lpozdneev/team-buzz/Website/images/mayur.png

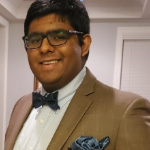
Website/images/mayur.png
