lpozdneev/team-buzz/Website/documents/pres1.pdf

Team Buzz: Stefan Abi-Karam, Evan Burke, Abigail Ivemeyer, Leonid Pozdneev, Mayur Singh, & Ethan Taylor

## HyTech Racing BMS: Presentation 1

02/17/2021

1. Introduction/Background (Abi)
2. Categories of Prior Art (Ethan)
3. Existing Products/Prior Art/Applicable Patents (Ethan)
4. Prior Art/HyTech BMS Design (Leo)
5. Customer Requirements/Design Specifications (Leo)
6. Design Concept Ideation: General System Diagram (Stefan)
7. Design Concept Ideation: Morphological Chart (Evan+Mayur)
8. Design Concept Ideation: Electrical System Diagram (Stefan)

### Order of Presentation

- HyTech racing is interested in a custom battery management
system, a data recording
system, and a user interface for charging Lithium Cobalt Oxide pouch battery cells

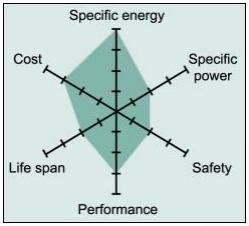
[picture p7: figure]

- The end goal is efficient battery charging and health estimation

### Introduction / Background

- Lithium Cobalt Oxide batteries are used because of their high specific energy but are limited by short lifespans

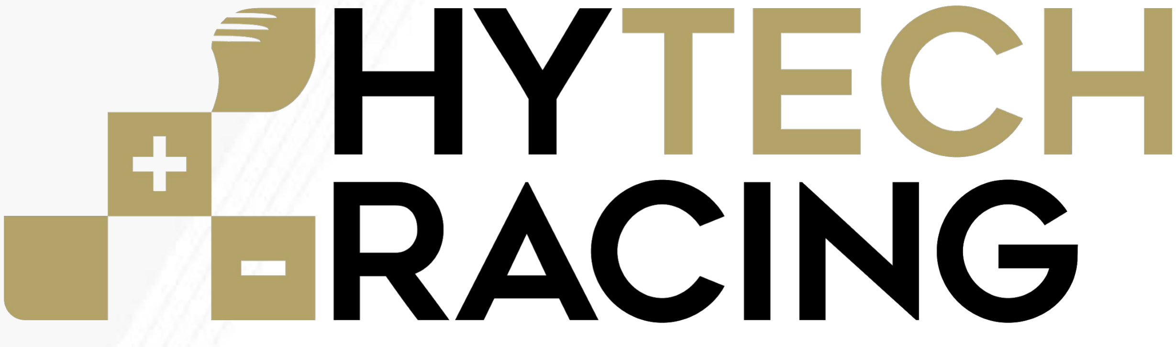
[picture p8: figure]

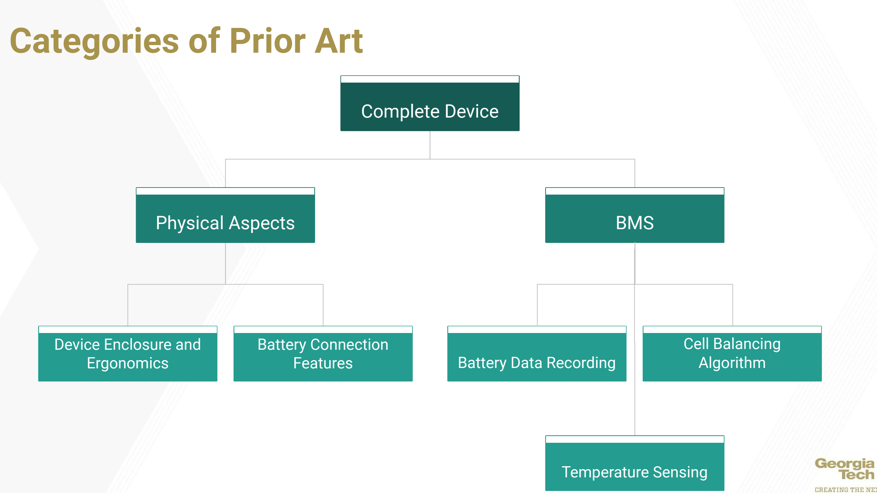
[picture p9: figure]
Complete Device; Physical Aspects; BMS; Cell Balancing; Battery Data Recording; Algorithm; Battery Connection Features; Device Enclosure and Ergonomics; Temperature Sensing; Categories of Prior Art

HyTech Racing:
- Already have a
pre-existing BMS design
utilizes LTC6804 Multicell Battery Monitors with
voltage logging using a
Tensey 3.2 microcontoller
- This design has already
been thoroughly tested
- More functionality is still to desired (logging
storage, temperature
monitoring, mechanical
design)

### Existing Products / Prior Art / Applicable Patents

Orion BMS
- Was used previously by
HyTech
- Has many great features
and is field programmable
- Orion BMS in the end was not a desirable solution for HyTech
- Large size and weight
- A lot of features that were not needed

Patents

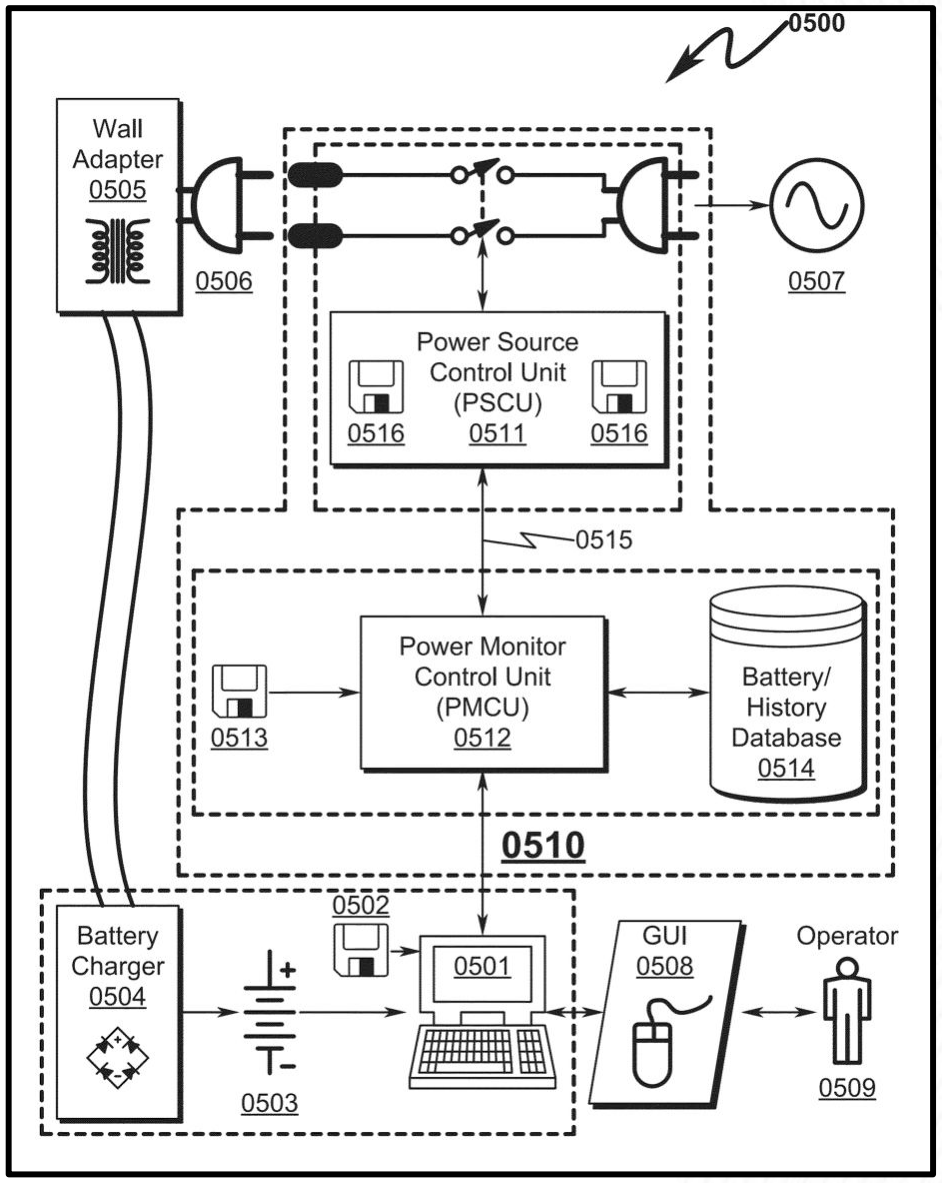
[picture p10: figure]

### Prior Art: HyTech BMS Design

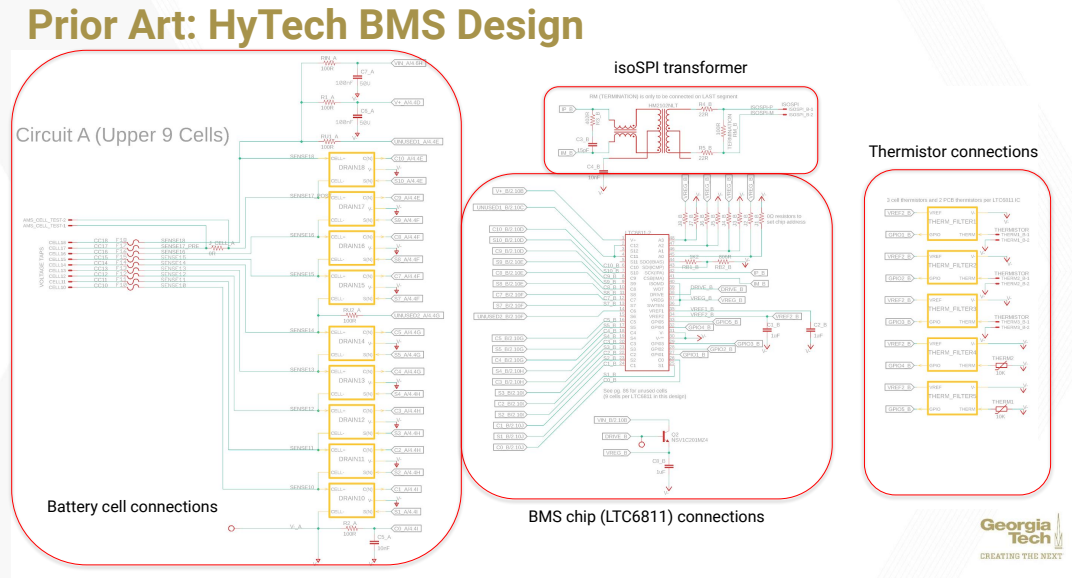
[picture p11: page 6]
isoSPI transformer; Thermistor connections

Battery cell connections

BMS chip (LTC6811) connections

### Prior Art: HyTech BMS Design

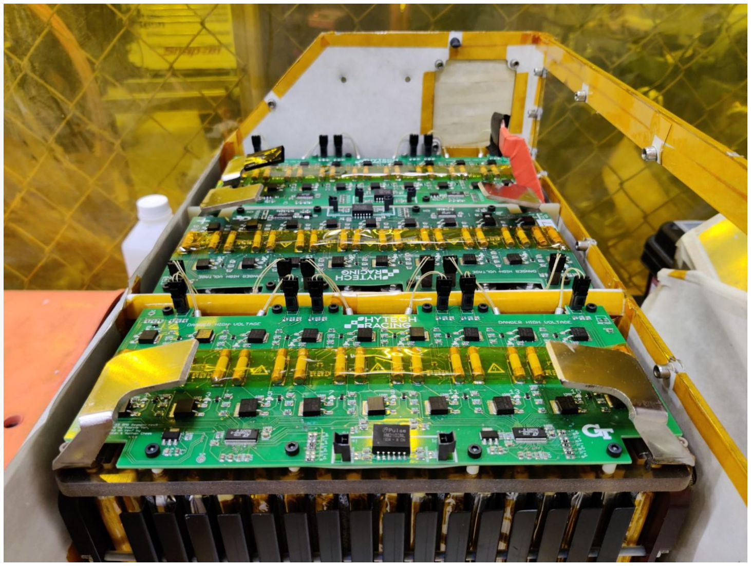
[picture p12: figure]

- Function
- Charge 9 LiCoO2 Battery Cells with nominal capacity of 18Ah
- Record and store current and voltage data for every cell
- Must be compatible with Melasta SLPBA580183 battery cells
- Electrical Characteristics
- Charging current of 9A (0.5C)
- Must have a cell balancing algorithm
- Powered from a regular electrical wall outlet
- Safety
- Must be easy and safe to use

Customer Requirements / Design Specifications

### Design Concept Ideation: General System Diagram

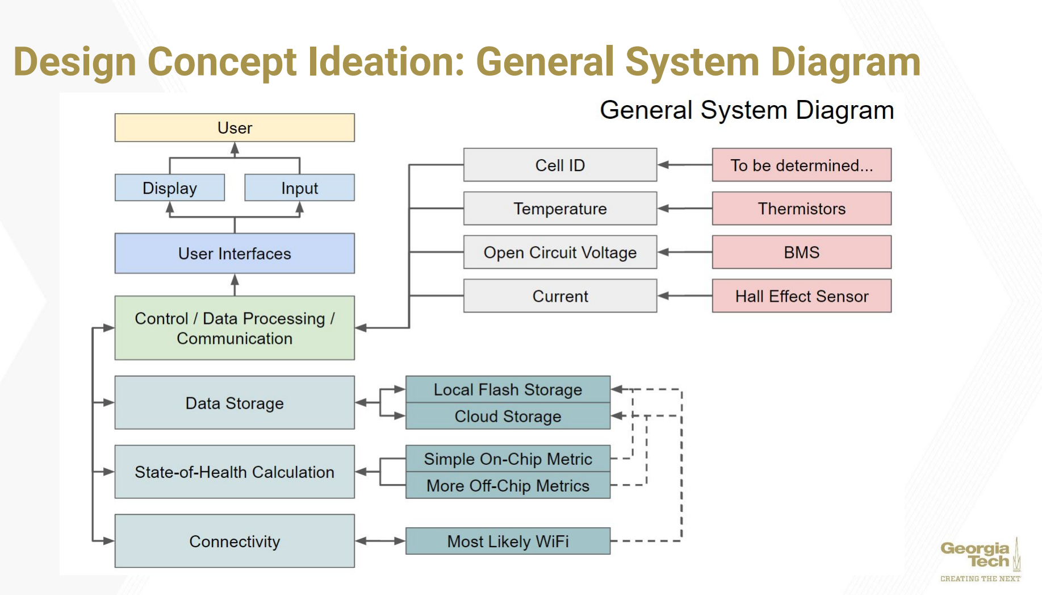
[picture p13: page 9]

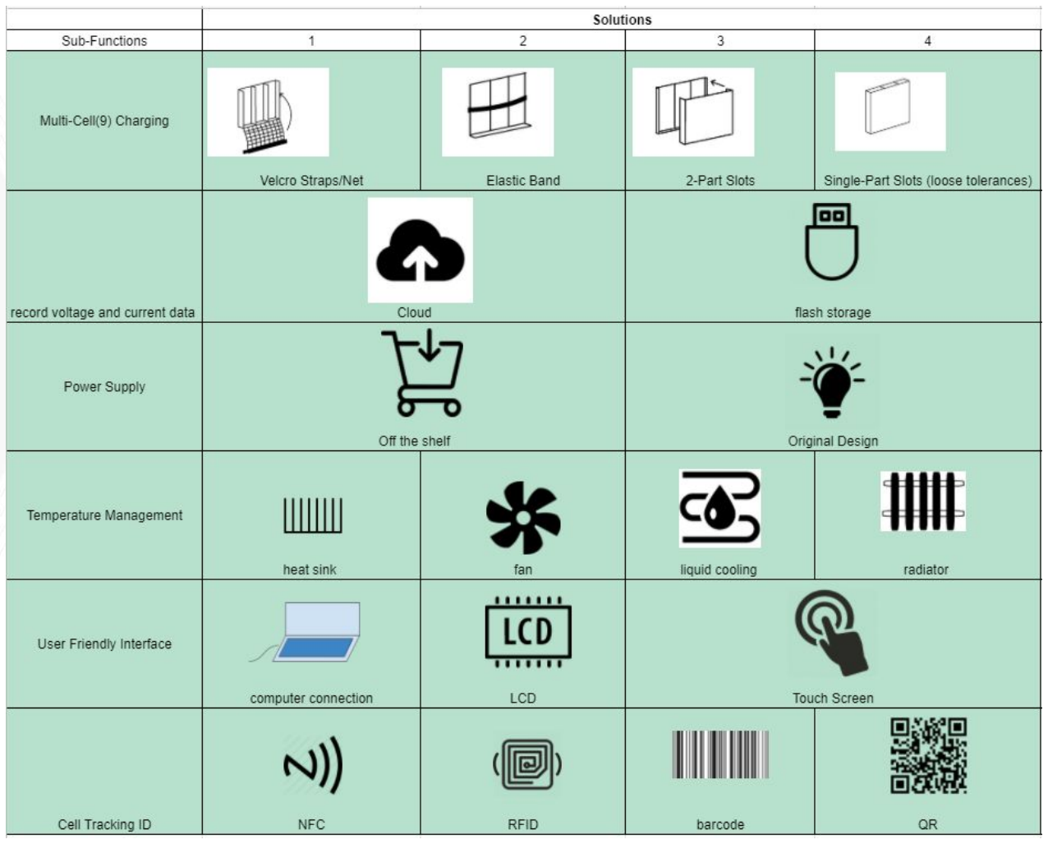
[picture p14: figure]

Morphological Chart:

### Design Concept Ideation

### Design Concept Ideation: Electrical System Diagram

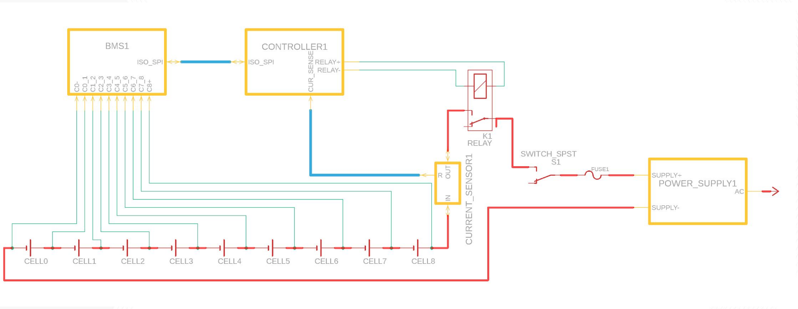
[picture p15: figure]
