lpozdneev/team-buzz/Battery Analysis/charge_data.png

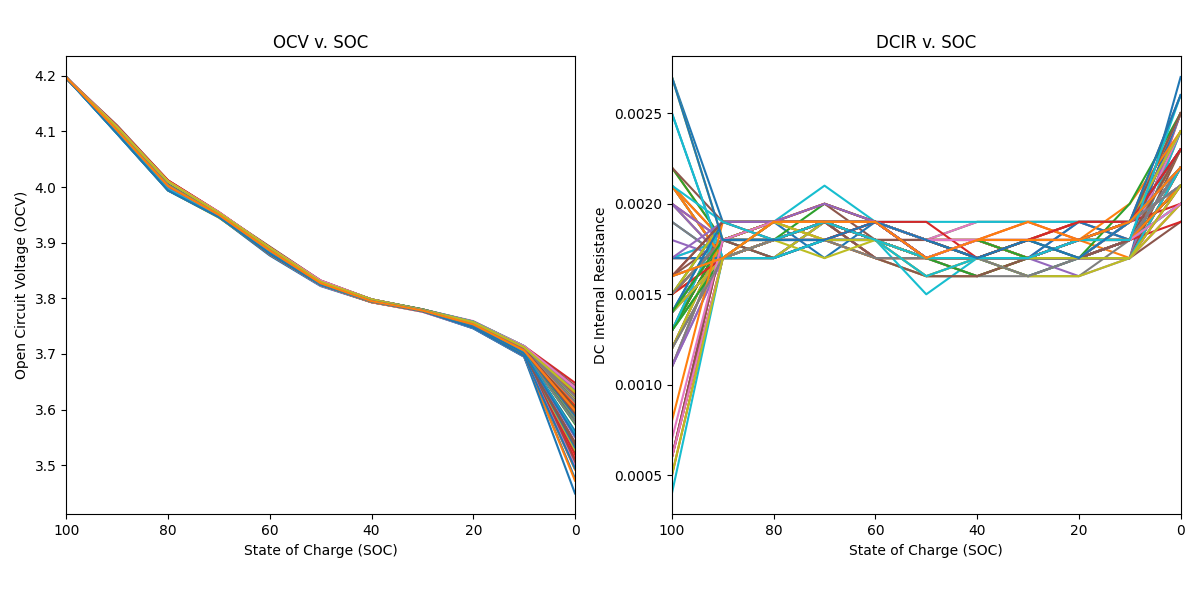
Battery Analysis/charge_data.png
