lpozdneev/team-buzz/Schematics/Cell Charger Controller/Cell Charger Controller rev1 brd.png

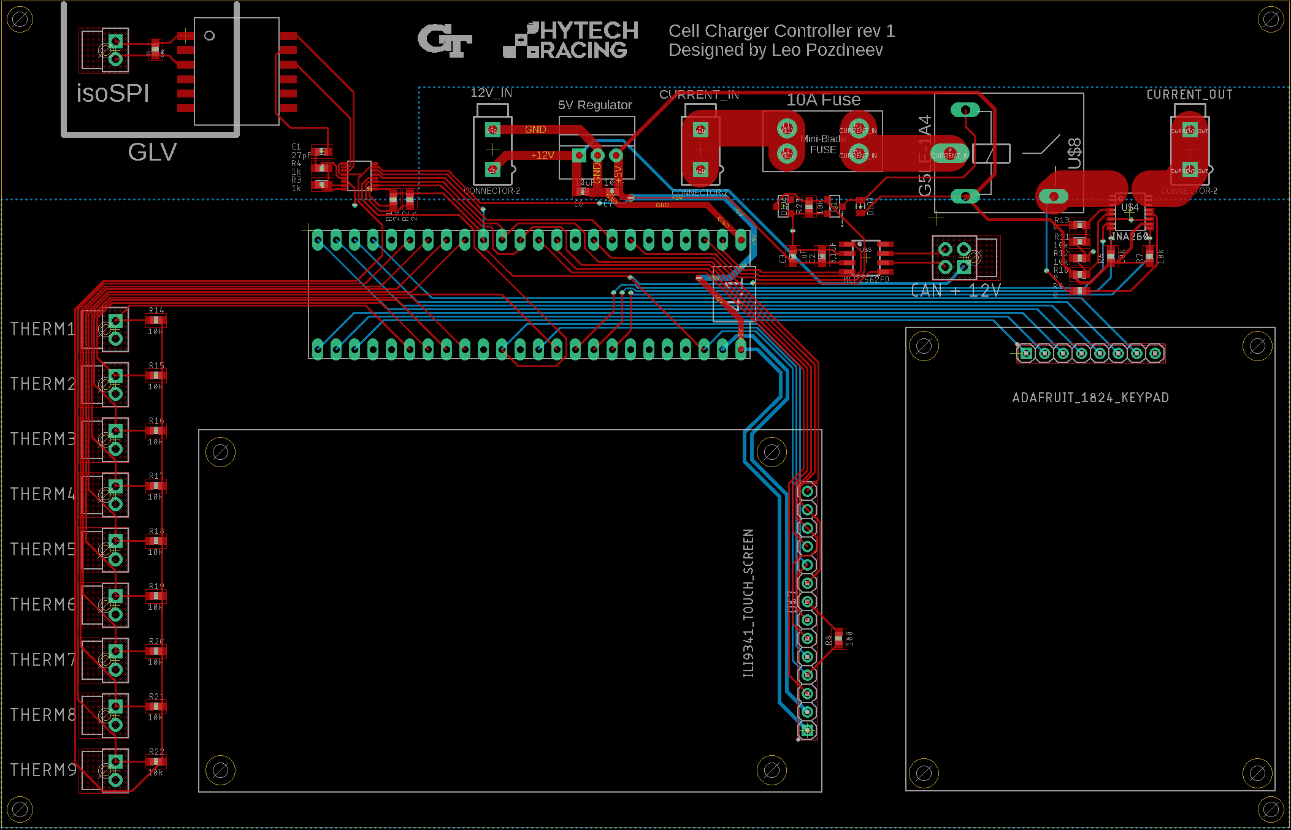
Schematics/Cell Charger Controller/Cell Charger Controller rev1 brd.png
