lpozdneev/team-buzz/Schematics/Cell Charger Controller/Cell Charger Controller rev1 sch.png

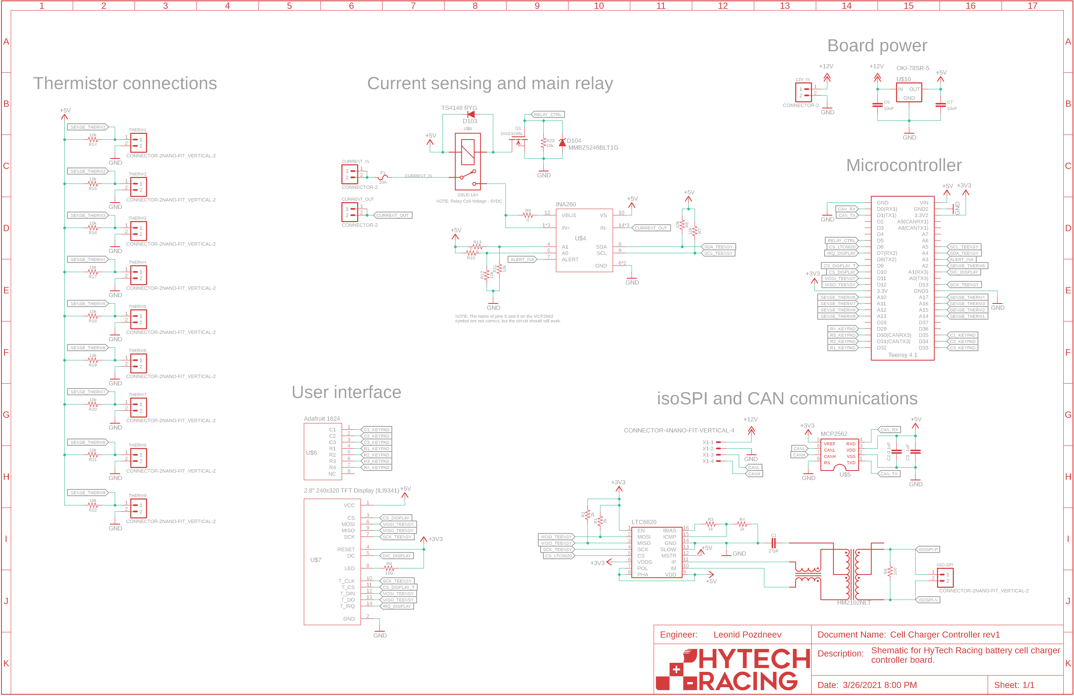
Schematics/Cell Charger Controller/Cell Charger Controller rev1 sch.png
