lpozdneev/team-buzz/Schematics/HyTech BMS Segment/BMS Segment rev 14 cell connections.png

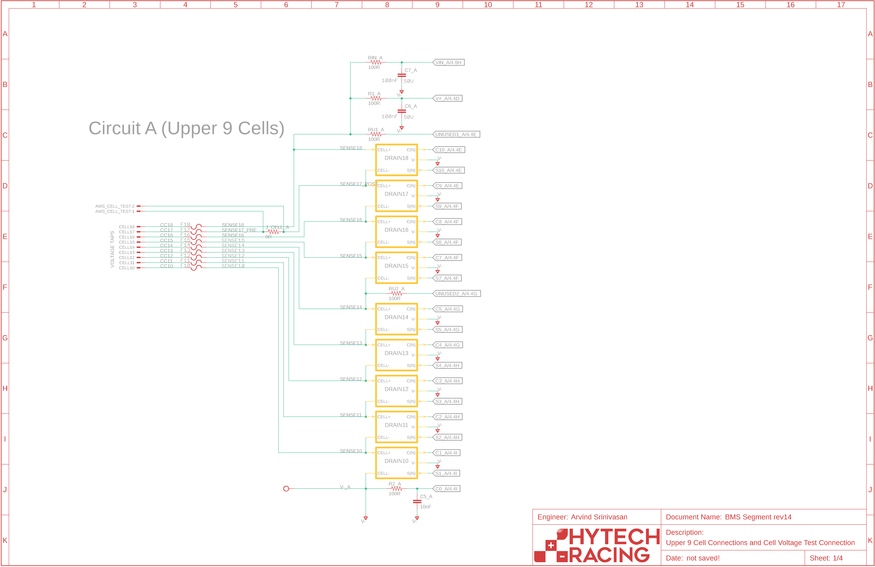
Schematics/HyTech BMS Segment/BMS Segment rev 14 cell connections.png
