lpozdneev/team-buzz/Schematics/System Diagrams/Full System Diagram rev1.png

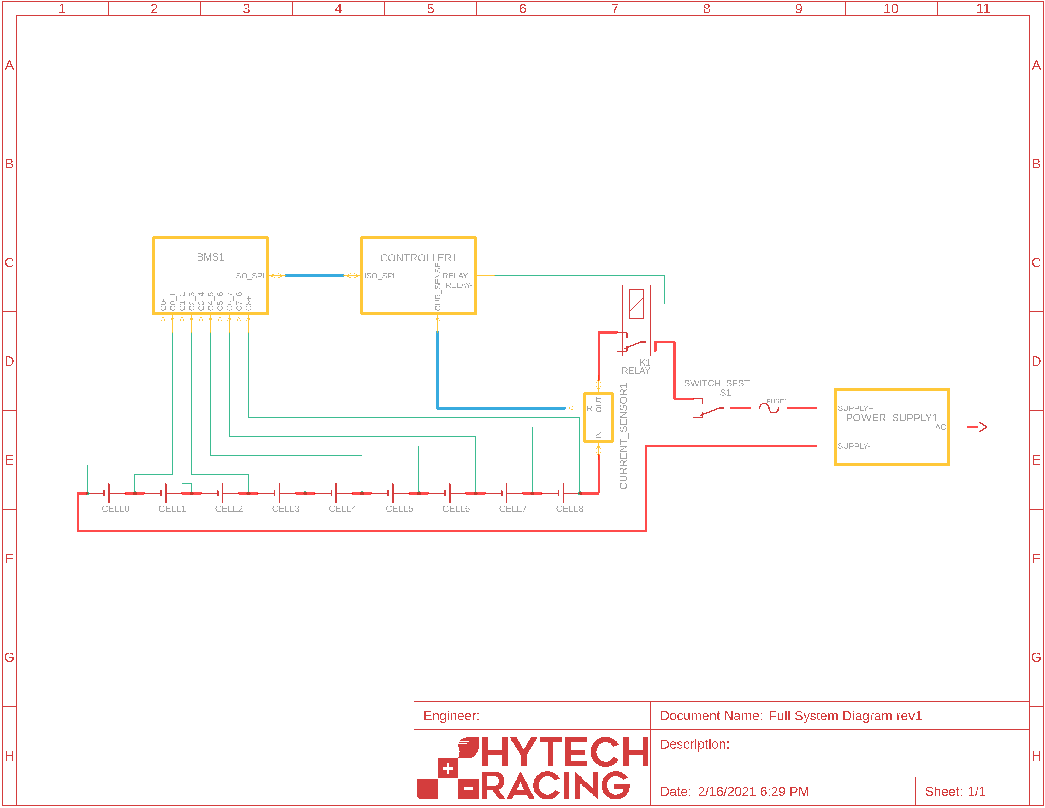
Schematics/System Diagrams/Full System Diagram rev1.png
