lpozdneev/team-buzz/Website/images/abigail.png

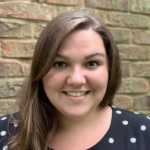
Website/images/abigail.png
