lpozdneev/team-buzz/Website/images/ethan.png

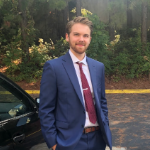
Website/images/ethan.png
