lpozdneev/team-buzz/Website/images/evan.png

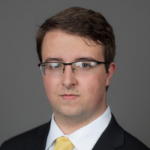
Website/images/evan.png
