lpozdneev/team-buzz/Website/images/leo.png

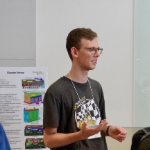
Website/images/leo.png
