lpozdneev/team-buzz/Website/images/new_bms.jpg

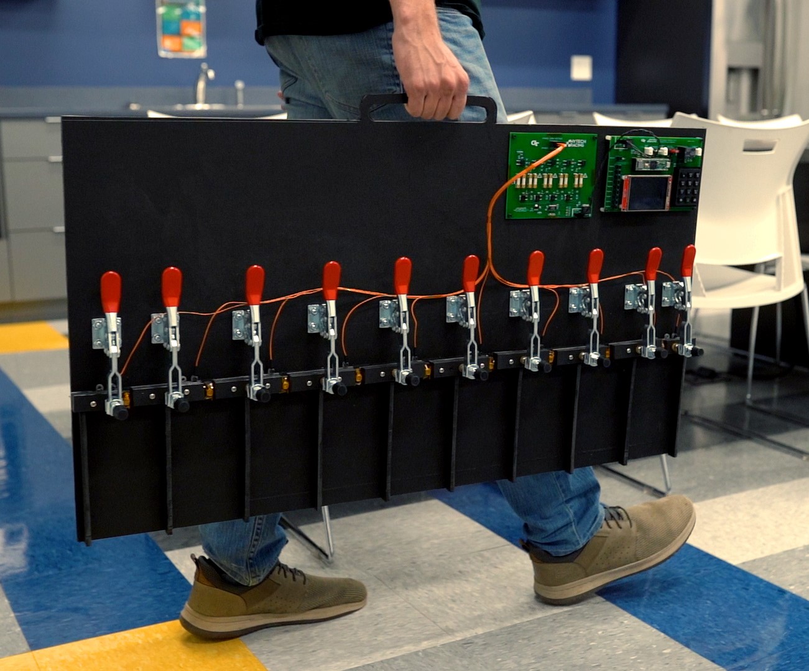
Website/images/new_bms.jpg
