lpozdneev/team-buzz/Website/images/original/abigail.png

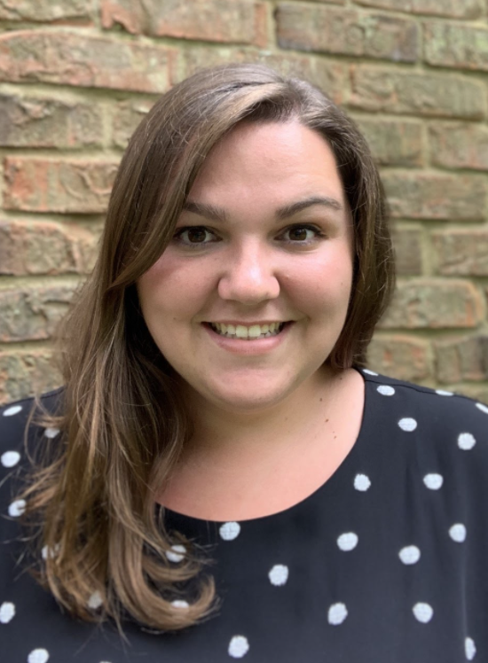
Website/images/original/abigail.png
