lpozdneev/team-buzz/Website/images/original/ethan.png

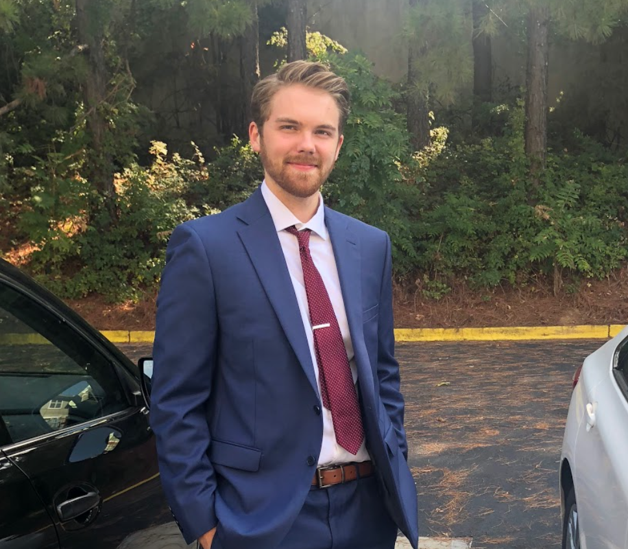
Website/images/original/ethan.png
