lpozdneev/team-buzz/Website/images/original/mayur.png

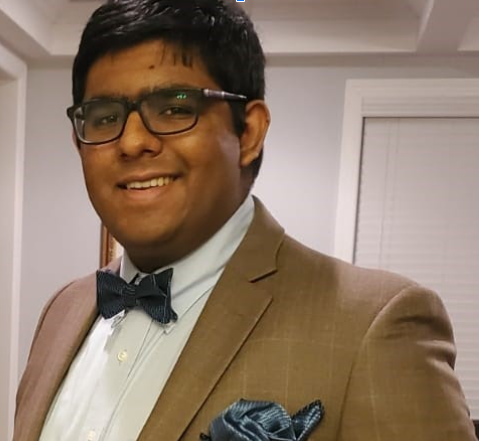
Website/images/original/mayur.png
