lpozdneev/team-buzz/Website/images/original/stefan.png

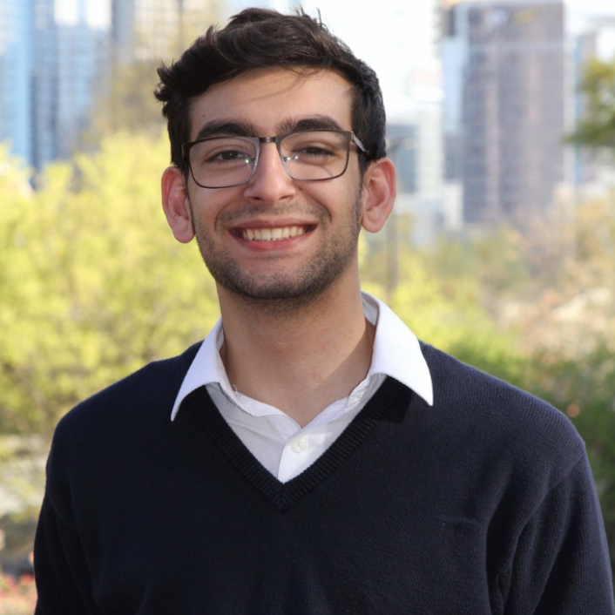
Website/images/original/stefan.png
