lpozdneev/team-buzz/Battery Analysis/HyTech Racing Cell Validation Summary.xlsx

Sheet: Initials
 | Unit # | Incoming OCV | AC Impedance | 0.2C Capacity | 70% DCIR |  |  | Cell # | 70% DCIR
60 | 20034 | 3.817 | < 1 mΩ | 18.748 | 0.00191 | 0.00017 |  | 20034 | 0.00191
99 | 20044 | 3.817 | < 1 mΩ | 18.936 | 0.00191 | 0.00017 |  | 20044 | 0.00191
48 | 20059 | 3.819 | < 1 mΩ | 18.747 | 0.00191 | 0.00017 |  | 20059 | 0.00191
18 | 20049 | 3.817 | < 1 mΩ | 18.584 | 0.00191 | 0.00017 |  | 20049 | 0.00191
7 | 20063 | 3.820 | < 1 mΩ | 18.611 | 0.00191 | 0.00017 |  | 20063 | 0.00191
6 | 20007 | 3.819 | < 1 mΩ | 18.565 | 0.00191 | 0.00017 |  | 20007 | 0.00191
80 | 20102 | 3.821 | < 1 mΩ | 18.551 | 0.00191 | 0.00017 |  | 20102 | 0.00191
29 | 20066 | 3.818 | < 1 mΩ | 18.880 | 0.00191 | 0.00017 |  | 20066 | 0.00191
40 | 20048 | 3.819 | < 1 mΩ | 18.693 | 0.00191 | 0.00017 |  | 20048 | 0.00191
79 | 20067 | 3.819 | < 1 mΩ | 18.745 | 0.00191 | 0.00017 |  | 20067 | 0.00191
35 | 20027 | 3.819 | < 1 mΩ | 18.635 | 0.00191 | 0.00017 |  | 20027 | 0.00191
20 | 20064 | 3.821 | < 1 mΩ | 18.833 | 0.00191 | 0.00017 |  | 20064 | 0.00191
17 | 20042 | 3.819 | < 1 mΩ | 18.758 | 0.00191 | 0.00017 |  | 20042 | 0.00191
73 | 20073 | 3.819 | < 1 mΩ | 18.637 | 0.00191 | 0.00017 |  | 20073 | 0.00191
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
