lpozdneev/team-buzz/Schematics/Cell Charger Controller/Cell Charger Controller rev1.brd

## EAGLE design Schematics/Cell Charger Controller/Cell Charger Controller rev1.brd (2021-03-30)

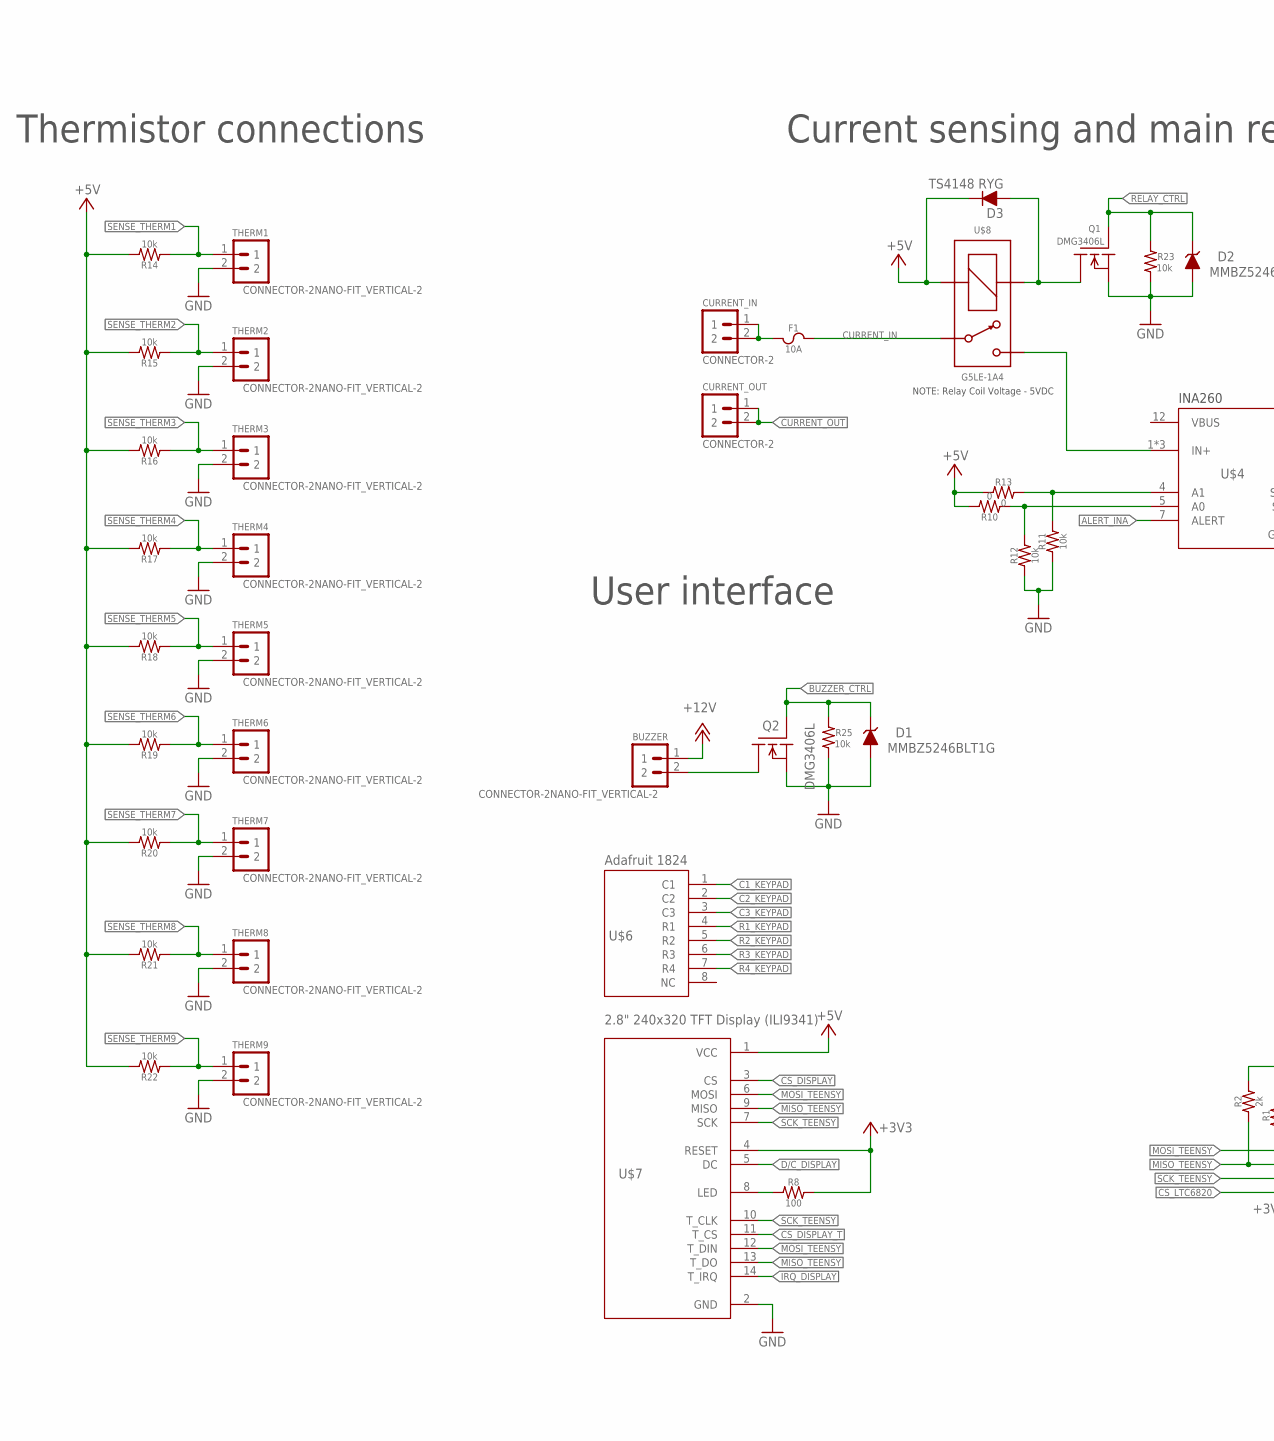
[picture p31: schematic Cell Charger Controller rev1.sch, part in row 1, column 1]

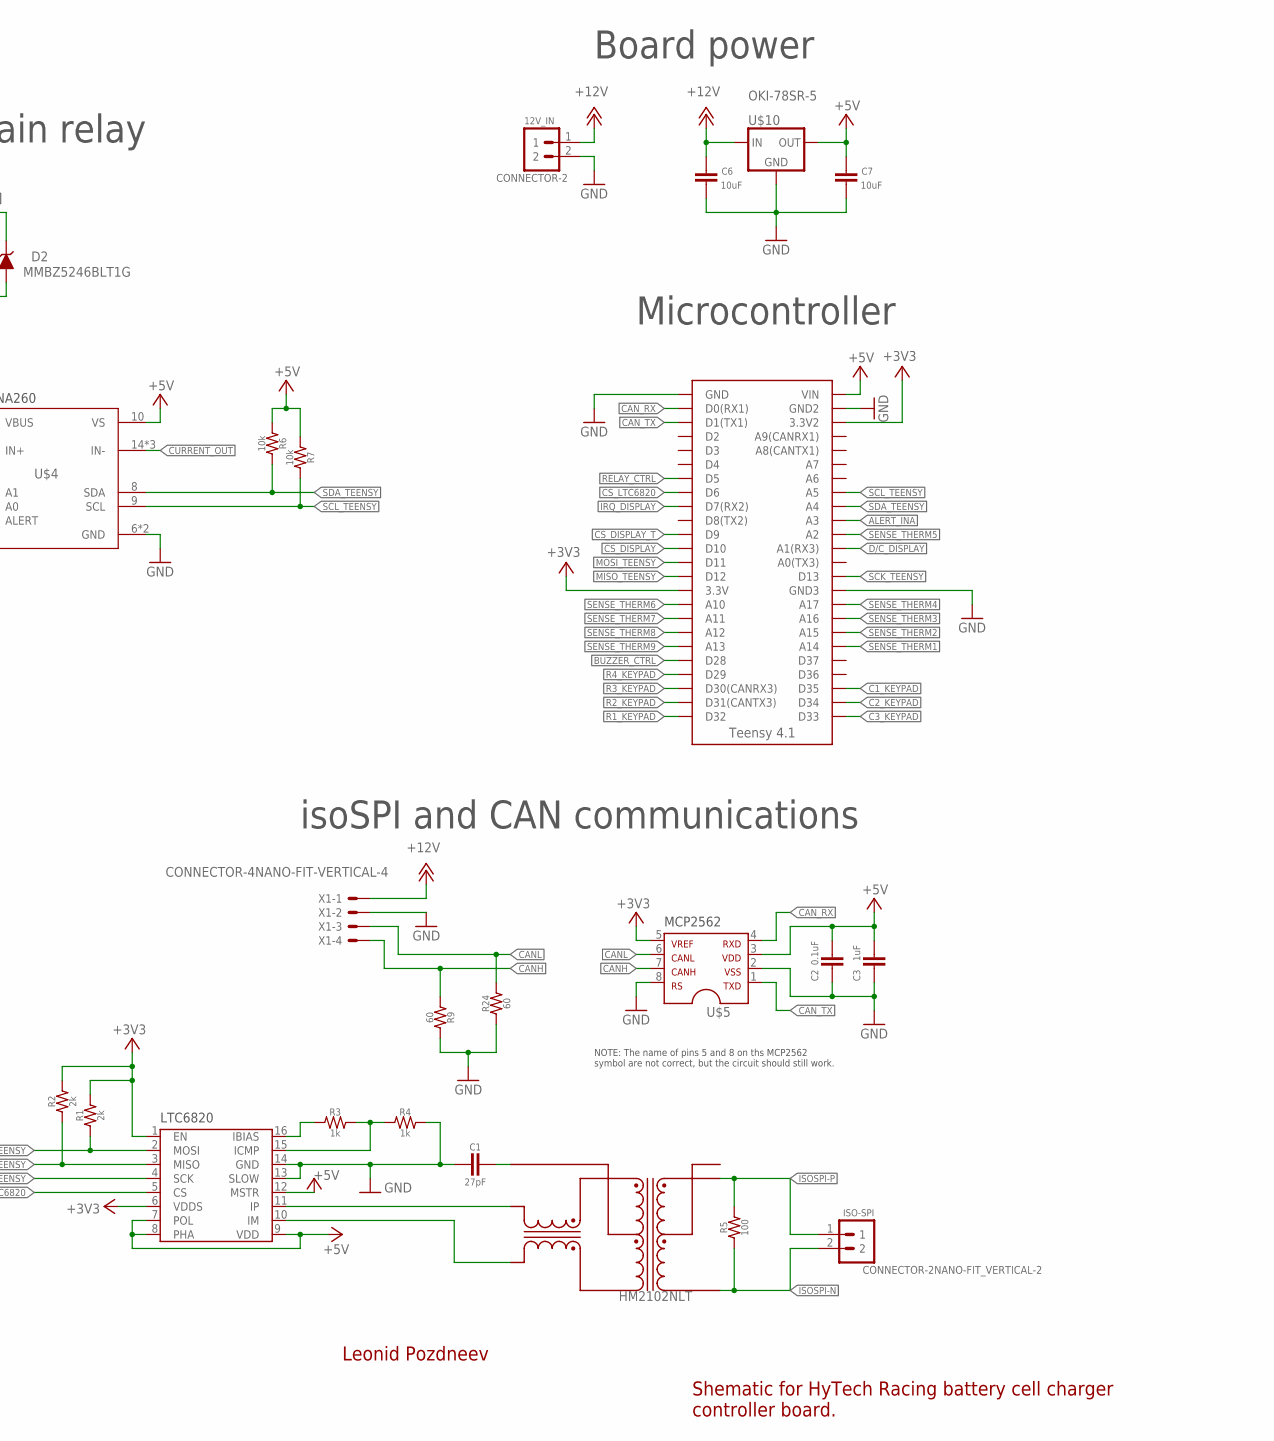
[picture p32: schematic Cell Charger Controller rev1.sch, part in row 1, column 2]

Parts:
12V_IN: CONNECTOR-2; 39288020
BUZZER: CONNECTOR-2NANO-FIT_VERTICAL-2; 1053091202
C1: 27pF; 0603-CAP
C2: 0.1uF; 0603-CAP
C3: 1uF; 0603-CAP
C6, C7: 10uF; 0603-CAP
CURRENT_IN: CONNECTOR-2; 39288020
CURRENT_OUT: CONNECTOR-2; 39288020
D1, D2: MMBZ5246BLT1G; SOT23
D3: TS4148 RYG; 0805_D
F1: 10A; MINI-BLADE_FUSE_HOLDER
ISO-SPI: CONNECTOR-2NANO-FIT_VERTICAL-2; 1053091202
Q1, Q2: DMG3406L; SOT23
R1, R2: 2k; 0603-RES
R3, R4: 1k; 0603-RES
R5, R8: 100; 0603-RES
R6, R7, R11, R12, R14, R15, R16, R17, R18, R19, R20, R21, R22, R23, R25: 10k; 0603-RES
R9, R24: 60; 0603-RES
R10, R13: 0; 0603-RES
THERM1, THERM2, THERM3, THERM4, THERM5, THERM6, THERM7, THERM8, THERM9: CONNECTOR-2NANO-FIT_VERTICAL-2; 1053091202
U1: HM2102NLT
U$2: TEENSY_4.1_SIMPLE
U$3: LTC6820; MSOP-16
U$4: INA260; TSSOP-16
U$5: MCP2562FD; SOIC-08
U$6: ADAFRUIT_1824_KEYPAD
U$7: ILI9341_TOUCH_SCREEN
U$8: G5LE-1A4
U$10: OKI-78SR-5; OKI-78SR
X1: CONNECTOR-4NANO-FIT-VERTICAL-4; 1053101204

Connections:
+3V3: R1.2, R2.2, R8.2, U$2.3.3V, U$2.3.3V2, U$3.1 (EN), U$3.6 (VDDS), U$5.5, U$7.4 (RESET)
+5V: C2.1, C3.1, C7.1, D3.C, R6.1, R7.1, R10.2, R13.1, R14.2, R15.2, R16.2, R17.2, R18.2, R19.2, R20.2, R21.2, R22.2, U$2.VIN, U$3.7 (POL), U$3.8 (PHA), U$3.9 (VDD), U$3.12 (MSTR), U$4.10 (VS), U$5.3, U$7.1 (VCC), U$8.2 (COIL-), U$10.3 (OUT)
+12V: 12V_IN.1, BUZZER.1, C6.1, U$10.1 (IN), X1.1
ALERT_INA: U$2.A3, U$4.7 (ALERT)
BUZZER_CTRL: D1.3 (C), Q2.1 (G), R25.2, U$2.D28
C1_KEYPAD: U$2.D35, U$6.1 (C1)
C2_KEYPAD: U$2.D34, U$6.2 (C2)
C3_KEYPAD: U$2.D33, U$6.3 (C3)
CANH: R9.1, U$5.7, X1.4
CANL: R24.2, U$5.6, X1.3
CAN_RX: U$2.D0(RX1), U$5.4
CAN_TX: U$2.D1(TX1), U$5.1
CS_DISPLAY: U$2.D10, U$7.3 (CS)
CS_DISPLAY_T: U$2.D9, U$7.11 (T_CS)
CS_LTC6820: U$2.D6, U$3.5 (CS)
CURRENT_IN: F1.R1 (2), F1.R2 (2), U$8.P
CURRENT_OUT: CURRENT_OUT.1, CURRENT_OUT.2, U$4.14 (IN-), U$4.15 (IN-), U$4.16 (IN-)
D/C_DISPLAY: U$2.A1(RX3), U$7.5 (DC)
GND: 12V_IN.2, C1.2, C2.2, C3.2, C6.2, C7.2, D1.1 (A), D2.1 (A), Q1.2 (S), Q2.2 (S), R4.2, R9.2, R11.1, R12.1, R23.1, R24.1, R25.1, THERM1.2, THERM2.2, THERM3.2, THERM4.2, THERM5.2, THERM6.2, THERM7.2, THERM8.2, THERM9.2, U$2.GND, U$2.GND2, U$2.GND3, U$3.13 (SLOW), U$3.14 (GND), U$4.6 (GND), U$4.11 (GND), U$5.2, U$5.8, U$7.2 (GND), U$10.2 (GND), X1.2
IRQ_DISPLAY: U$2.D7(RX2), U$7.14 (T_IRQ)
ISOSPI-N: ISO-SPI.2, R5.1, U1.P$3 (MX-)
ISOSPI-P: ISO-SPI.1, R5.2, U1.P$1 (MX+)
MISO_TEENSY: R2.1, U$2.D12, U$3.3 (MISO), U$7.9 (MISO), U$7.13 (T_DO)
MOSI_TEENSY: R1.1, U$2.D11, U$3.2 (MOSI), U$7.6 (MOSI), U$7.12 (T_DIN)
unnamed: C1.1, U1.P$11 (TCT)
unnamed: U1.P$12 (TD+), U$3.11 (IP)
unnamed: U1.P$10 (TD-), U$3.10 (IM)
unnamed: R3.1, U$3.16 (IBIAS)
unnamed: R3.2, R4.1, U$3.15 (ICMP)
unnamed: R11.2, R13.2, U$4.4 (A1)
unnamed: R10.1, R12.2, U$4.5 (A0)
unnamed: R8.1, U$7.8 (LED)
unnamed: CURRENT_IN.1, CURRENT_IN.2, F1.L1 (1), F1.L2 (1)
unnamed: U$4.1 (IN+), U$4.2 (IN+), U$4.3 (IN+), U$8.S
unnamed: D3.A, Q1.3 (D), U$8.1 (COIL+)
unnamed: BUZZER.2, Q2.3 (D)
R1_KEYPAD: U$2.D32, U$6.4 (R1)
R2_KEYPAD: U$2.D31(CANTX) (D31(CANTX3)), U$6.5 (R2)
R3_KEYPAD: U$2.D30(CANRX) (D30(CANRX3)), U$6.6 (R3)
R4_KEYPAD: U$2.D29, U$6.7 (R4)
RELAY_CTRL: D2.3 (C), Q1.1 (G), R23.2, U$2.D5
SCK_TEENSY: U$2.D13, U$3.4 (SCK), U$7.7 (SCK), U$7.10 (T_CLK)
SCL_TEENSY: R7.2, U$2.A5, U$4.9 (SCL)
SDA_TEENSY: R6.2, U$2.A4, U$4.8 (SDA)
SENSE_THERM1: R14.1, THERM1.1, U$2.A14
SENSE_THERM2: R15.1, THERM2.1, U$2.A15
SENSE_THERM3: R16.1, THERM3.1, U$2.A16
SENSE_THERM4: R17.1, THERM4.1, U$2.A17
SENSE_THERM5: R18.1, THERM5.1, U$2.A2
SENSE_THERM6: R19.1, THERM6.1, U$2.A10
SENSE_THERM7: R20.1, THERM7.1, U$2.A11
SENSE_THERM8: R21.1, THERM8.1, U$2.A12
SENSE_THERM9: R22.1, THERM9.1, U$2.A13

Notes on the sheet:
NOTE: The name of pins 5 and 8 on ths MCP2562 symbol are not correct, but the circuit should still work.
INA260
MCP2562
LTC6820
NOTE: Relay Coil Voltage - 5VDC
Leonid Pozdneev
Shematic for HyTech Racing battery cell charger controller board.
User interface
Thermistor connections
Current sensing and main relay
Microcontroller
isoSPI and CAN communications
Board power

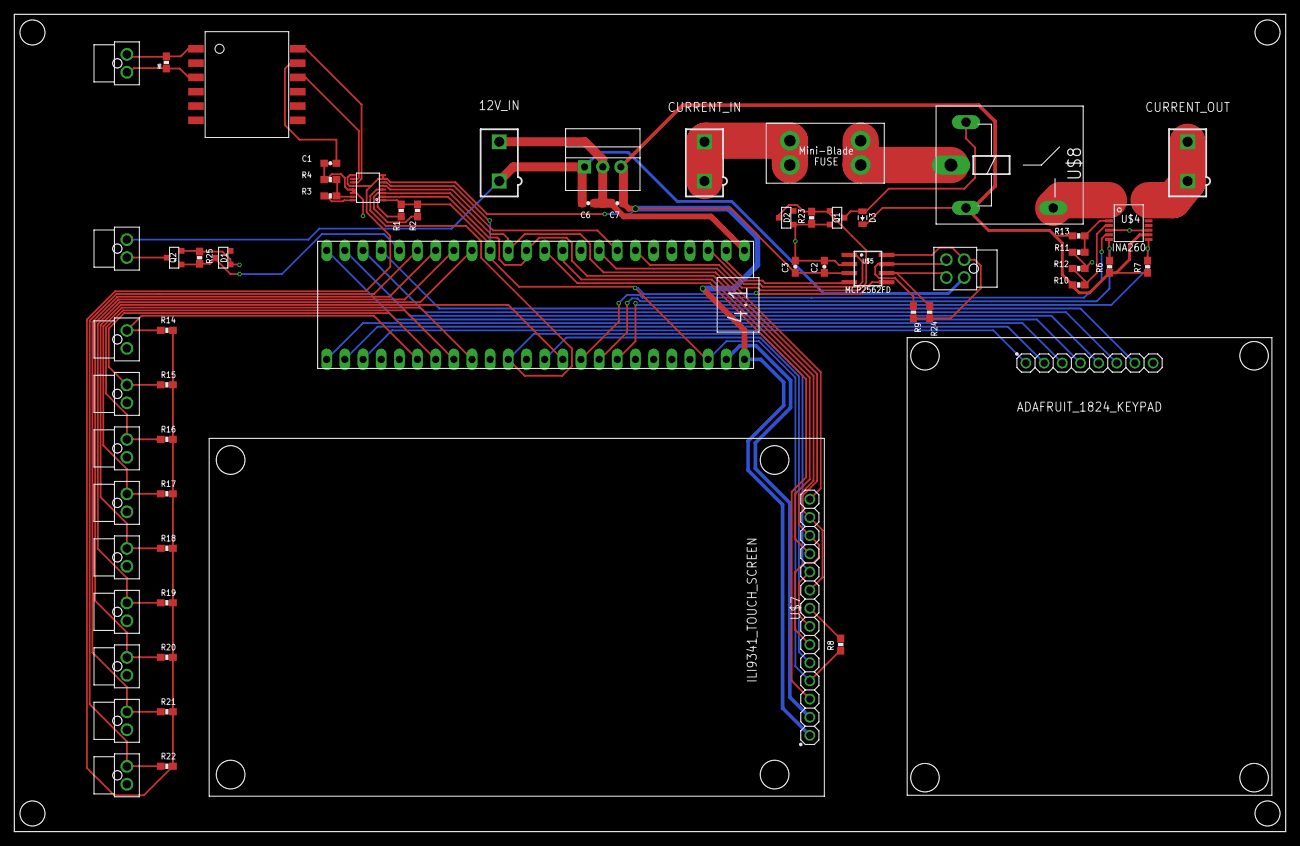
[picture p33: board Cell Charger Controller rev1.brd from above]

Board: 2 copper layers, 177.8 x 114.3 mm, 60 parts (0 on the bottom side), 53 nets.
