lpozdneev/team-buzz/Schematics/Cell Charger BMS/Cell Charger BMS rev1.brd

## EAGLE design Schematics/Cell Charger BMS/Cell Charger BMS rev1.brd (2021-03-23)

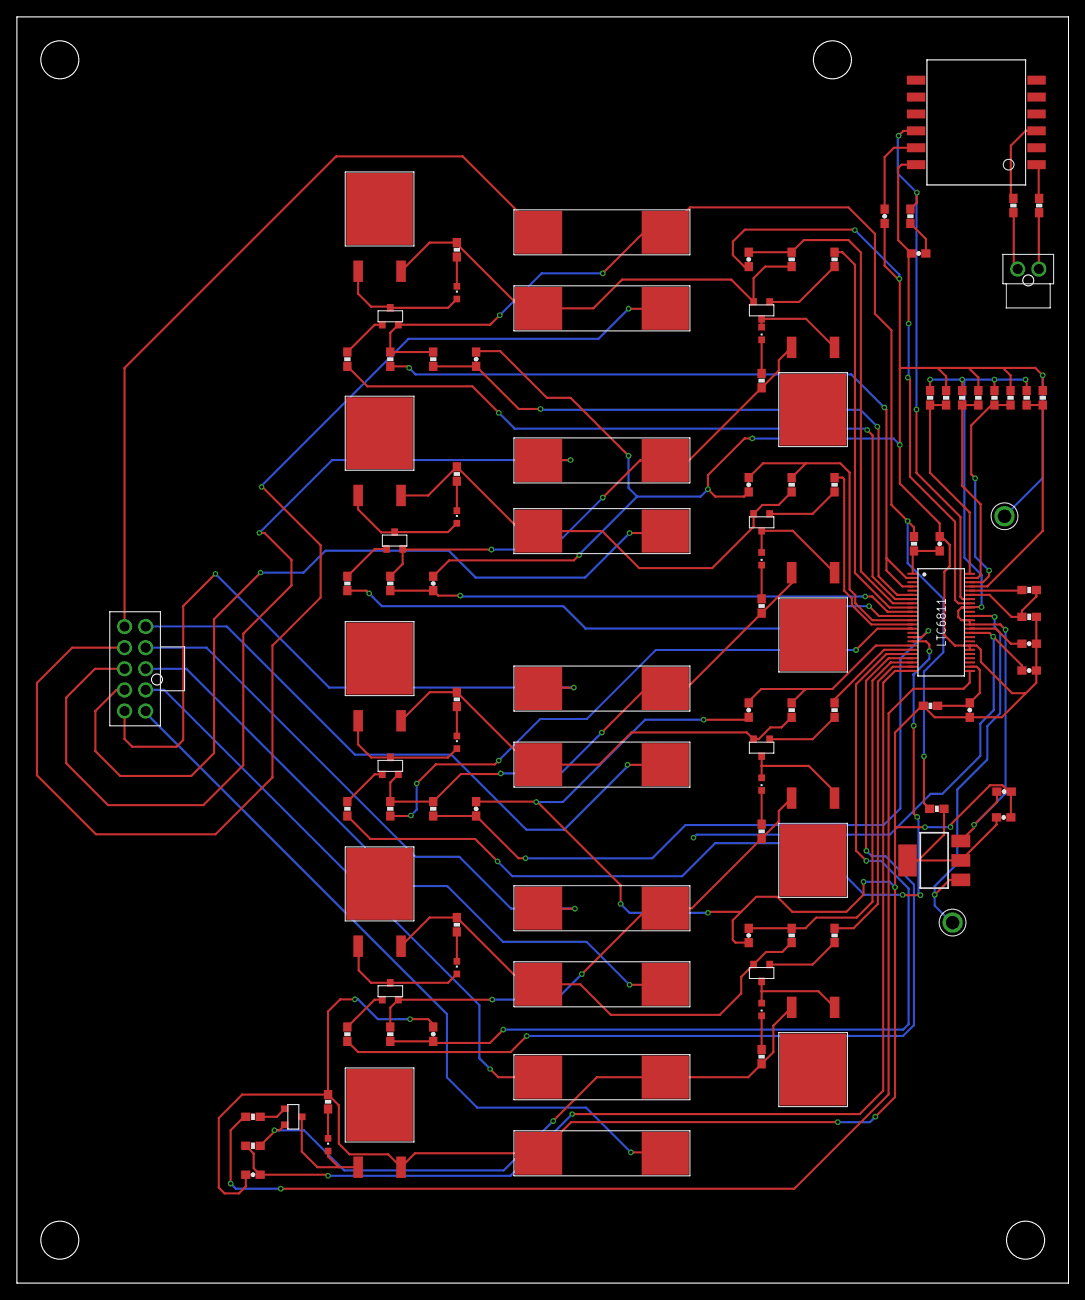
[picture p34: board Cell Charger BMS rev1.brd from above]

Board: 2 copper layers, 124.5 x 149.9 mm, 110 parts (0 on the bottom side), 88 nets.

Parts:
C1_B, C2_B, C8_B: 1uF; 0603-CAP
C3_B: 15pF; 0603-CAP
C4_B: 10nF; 0603-CAP
C6_B, C7_B: 100nF; 0603-CAP
C_5: 10nF; 0603-CAP
DRAIN1:C, DRAIN2:C, DRAIN3:C, DRAIN4:C, DRAIN5:C, DRAIN6:C, DRAIN7:C, DRAIN8:C, DRAIN9:C: 10nF; 0603-CAP
DRAIN1:DISCHARGE, DRAIN2:DISCHARGE, DRAIN3:DISCHARGE, DRAIN4:DISCHARGE, DRAIN5:DISCHARGE, DRAIN6:DISCHARGE, DRAIN7:DISCHARGE, DRAIN8:DISCHARGE, DRAIN9:DISCHARGE: 5R; PWR163
DRAIN1:GATE, DRAIN2:GATE, DRAIN3:GATE, DRAIN4:GATE, DRAIN5:GATE, DRAIN6:GATE, DRAIN7:GATE, DRAIN8:GATE, DRAIN9:GATE: 3K3; 0603-RES
DRAIN1:LED1, DRAIN2:LED1, DRAIN3:LED1, DRAIN4:LED1, DRAIN5:LED1, DRAIN6:LED1, DRAIN7:LED1, DRAIN8:LED1, DRAIN9:LED1: RED; LED-603
DRAIN1:PFET, DRAIN2:PFET, DRAIN3:PFET, DRAIN4:PFET, DRAIN5:PFET, DRAIN6:PFET, DRAIN7:PFET, DRAIN8:PFET, DRAIN9:PFET: P-CHANNEL_MOSFET_DMP3099L-7; SOT23
DRAIN1:R, DRAIN2:R, DRAIN3:R, DRAIN4:R, DRAIN5:R, DRAIN6:R, DRAIN7:R, DRAIN8:R, DRAIN9:R: 100R; 0603-RES
DRAIN1:R1, DRAIN2:R1, DRAIN3:R1, DRAIN4:R1, DRAIN5:R1, DRAIN6:R1, DRAIN7:R1, DRAIN8:R1, DRAIN9:R1: 806R; 0603-RES
F0, F1, F2, F3, F4, F5, F6, F7, F8, F9: 0001.2704.11; 5X20MM_FUSE
J1_B, J2_B, J3_B, J4_B, J5_B, J6_B, J7_B, J8_B: 0R; 0603-RES
Q2: NSV1C201MZ4; SOT223
R1_B, R2_B: 100R; 0603-RES
R3_B: 402R; 0603-RES
R4_B, R5_B: 22R; 0603-RES
RB1_B: 1K2; 0603-RES
RB2_B: 806R; 0603-RES
RIN_B: 100R; 0603-RES
RU1_B, RU2_B: 100R; 0603-RES
TRANSFORMER: HM2102NLT
U2: LTC6811-2; LTC6811
U$6, U$7: TEST_POINT
U$13, U$14, U$16, U$27: M4_MOUNTING
X1: CONNECTOR-10NANO-FIT_VERTICAL-10; 1053101210
X2: CONNECTOR-2NANO-FIT_VERTICAL-2; 1053091202

Connections:
C0_B: C_5.1, R2_B.2, U2.26
C1_B: DRAIN1:C.1, DRAIN1:R.2, U2.24
C2_B: DRAIN2:C.1, DRAIN2:R.2, U2.22
C3_B: DRAIN3:C.1, DRAIN3:R.2, U2.20
C4_B: DRAIN4:C.1, DRAIN4:R.2, U2.18
C5_B: DRAIN5:C.1, DRAIN5:R.2, U2.16
C7_B: DRAIN6:C.1, DRAIN6:R.2, U2.12
C8_B: DRAIN7:C.1, DRAIN7:R.2, U2.10
C9_B: DRAIN8:C.1, DRAIN8:R.2, U2.8
C10_B: DRAIN9:C.1, DRAIN9:R.2, U2.6
CC0: F0.P$1, X1.P$1
CC1: F1.P$1, X1.P$2
CC2: F2.P$1, X1.P$3
CC3: F3.P$1, X1.P$4
CC4: F4.P$1, X1.P$5
CC5: F5.P$1, X1.P$6
CC6: F6.P$1, X1.P$7
CC7: F7.P$1, X1.P$8
CC8: F8.P$1, X1.P$9
DRAIN1:GATE: DRAIN1:GATE.1, DRAIN1:PFET.1
DRAIN1:N$1: DRAIN1:DISCHARGE.1, DRAIN1:LED1.A, DRAIN1:PFET.3
DRAIN1:N$2: DRAIN1:LED1.C, DRAIN1:R1.2
DRAIN2:GATE: DRAIN2:GATE.1, DRAIN2:PFET.1
DRAIN2:N$1: DRAIN2:DISCHARGE.1, DRAIN2:LED1.A, DRAIN2:PFET.3
DRAIN2:N$2: DRAIN2:LED1.C, DRAIN2:R1.2
DRAIN3:GATE: DRAIN3:GATE.1, DRAIN3:PFET.1
DRAIN3:N$1: DRAIN3:DISCHARGE.1, DRAIN3:LED1.A, DRAIN3:PFET.3
DRAIN3:N$2: DRAIN3:LED1.C, DRAIN3:R1.2
DRAIN4:GATE: DRAIN4:GATE.1, DRAIN4:PFET.1
DRAIN4:N$1: DRAIN4:DISCHARGE.1, DRAIN4:LED1.A, DRAIN4:PFET.3
DRAIN4:N$2: DRAIN4:LED1.C, DRAIN4:R1.2
DRAIN5:GATE: DRAIN5:GATE.1, DRAIN5:PFET.1
DRAIN5:N$1: DRAIN5:DISCHARGE.1, DRAIN5:LED1.A, DRAIN5:PFET.3
DRAIN5:N$2: DRAIN5:LED1.C, DRAIN5:R1.2
DRAIN6:GATE: DRAIN6:GATE.1, DRAIN6:PFET.1
DRAIN6:N$1: DRAIN6:DISCHARGE.1, DRAIN6:LED1.A, DRAIN6:PFET.3
DRAIN6:N$2: DRAIN6:LED1.C, DRAIN6:R1.2
DRAIN7:GATE: DRAIN7:GATE.1, DRAIN7:PFET.1
DRAIN7:N$1: DRAIN7:DISCHARGE.1, DRAIN7:LED1.A, DRAIN7:PFET.3
DRAIN7:N$2: DRAIN7:LED1.C, DRAIN7:R1.2
DRAIN8:GATE: DRAIN8:GATE.1, DRAIN8:PFET.1
DRAIN8:N$1: DRAIN8:DISCHARGE.1, DRAIN8:LED1.A, DRAIN8:PFET.3
DRAIN8:N$2: DRAIN8:LED1.C, DRAIN8:R1.2
DRAIN9:GATE: DRAIN9:GATE.1, DRAIN9:PFET.1
DRAIN9:N$1: DRAIN9:DISCHARGE.1, DRAIN9:LED1.A, DRAIN9:PFET.3
DRAIN9:N$2: DRAIN9:LED1.C, DRAIN9:R1.2
DRIVE_B: Q2.1, U2.38, U$7.P$1
IM_B: C3_B.2, TRANSFORMER.P$12, U2.41
IP_B: R3_B.1, TRANSFORMER.P$10, U2.42
ISOSPI-M: R5_B.2, X2.2
ISOSPI-P: R4_B.2, X2.1
unnamed: C4_B.1, TRANSFORMER.P$11
unnamed: RB1_B.2, U2.44
unnamed: F9.P$1, X1.P$10
unnamed: RB1_B.1, RB2_B.2, U2.43
unnamed: R4_B.1, TRANSFORMER.P$3
unnamed: R5_B.1, TRANSFORMER.P$1
unnamed: J7_B.1, J8_B.1, U2.48
unnamed: J5_B.1, J6_B.1, U2.47
unnamed: C3_B.1, R3_B.2
unnamed: J3_B.1, J4_B.1, U2.46
unnamed: J1_B.1, J2_B.1, U2.45
S1_B: DRAIN1:GATE.2, U2.25
S2_B: DRAIN2:GATE.2, U2.23
S3_B: DRAIN3:GATE.2, U2.21
S4_B: DRAIN4:GATE.2, U2.19
S5_B: DRAIN5:GATE.2, U2.17
S7_B: DRAIN6:GATE.2, U2.13
S8_B: DRAIN7:GATE.2, U2.11
S9_B: DRAIN8:GATE.2, U2.9
S10_B: DRAIN9:GATE.2, U2.7
SENSE1: DRAIN1:PFET.2, DRAIN1:R.1, DRAIN2:DISCHARGE.2, DRAIN2:R1.1, F1.P$2
SENSE2: DRAIN2:PFET.2, DRAIN2:R.1, DRAIN3:DISCHARGE.2, DRAIN3:R1.1, F2.P$2
SENSE3: DRAIN3:PFET.2, DRAIN3:R.1, DRAIN4:DISCHARGE.2, DRAIN4:R1.1, F3.P$2
SENSE4: DRAIN4:PFET.2, DRAIN4:R.1, DRAIN5:DISCHARGE.2, DRAIN5:R1.1, F4.P$2
SENSE5: DRAIN5:PFET.2, DRAIN5:R.1, DRAIN6:DISCHARGE.2, DRAIN6:R1.1, F5.P$2, RU2_B.1
SENSE6: DRAIN6:PFET.2, DRAIN6:R.1, DRAIN7:DISCHARGE.2, DRAIN7:R1.1, F6.P$2
SENSE7: DRAIN7:PFET.2, DRAIN7:R.1, DRAIN8:DISCHARGE.2, DRAIN8:R1.1, F7.P$2
SENSE8: DRAIN8:PFET.2, DRAIN8:R.1, DRAIN9:DISCHARGE.2, DRAIN9:R1.1, F8.P$2
UNUSED1_B: RU1_B.2, U2.2, U2.4
UNUSED2_B: RU2_B.2, U2.14
V+_B: C6_B.1, R1_B.2, U2.1
V-_A: DRAIN9:PFET.2, DRAIN9:R.1, F9.P$2, R1_B.1, RIN_B.1, RU1_B.1
V-_B: C1_B.2, C2_B.2, C4_B.2, C6_B.2, C7_B.2, C8_B.2, C_5.2, DRAIN1:C.2, DRAIN1:DISCHARGE.2, DRAIN1:R1.1, DRAIN2:C.2, DRAIN3:C.2, DRAIN4:C.2, DRAIN5:C.2, DRAIN6:C.2, DRAIN7:C.2, DRAIN8:C.2, DRAIN9:C.2, F0.P$2, J1_B.2, J3_B.2, J5_B.2, J7_B.2, R2_B.1, RB2_B.1, U2.30, U2.31, U$6.P$1
VIN_B: C7_B.1, Q2.2, Q2.4, RIN_B.2
VREF1_B: C2_B.1, U2.35
VREF2_B: C1_B.1, U2.34
VREG_B: C8_B.1, J2_B.2, J4_B.2, J6_B.2, J8_B.2, Q2.3, U2.36, U2.37, U2.40
