lpozdneev/team-buzz/Schematics/Adafruit-INA260-PCB-master/Adafruit INA260.brd

## EAGLE design Schematics/Adafruit-INA260-PCB-master/Adafruit INA260.brd (2021-03-20)

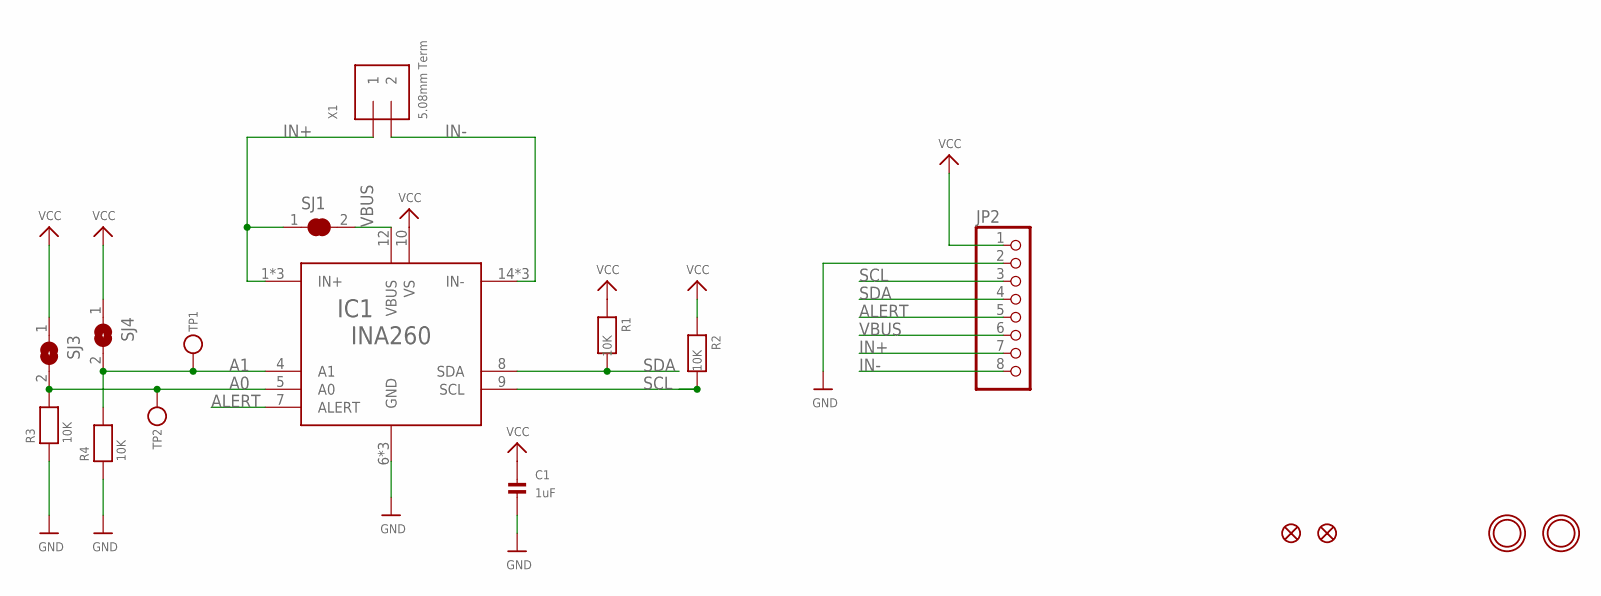
[picture p35: schematic Adafruit INA260.sch]

Parts:
C1: 1uF; 0603-NO
FID3, FID4: MICROBUILDER_FIDUCIAL""; MICROBUILDER_FIDUCIAL_1MM
IC1: INA260; TSSOP16
JP2: HEADER-1X870MIL; 1X08_ROUND_70
R1, R2, R3, R4: 10K; 0603-NO
SJ1: SOLDERJUMPER_CLOSED; SOLDERJUMPER_CLOSEDWIRE
SJ3, SJ4: SOLDERJUMPER; SOLDERJUMPER_ARROW_NOPASTE
TP1, TP2: TESTPOINTROUND1.5MM; TESTPOINT_ROUND_1.5MM
U$7, U$8: MOUNTINGHOLE2.5; MOUNTINGHOLE_2.5_PLATED
X1: 5.08mm Term; TERMBLOCK_508_1X2

Connections:
A0: IC1.5 (A0), R3.2, SJ3.2, TP2.P$1
A1: IC1.4 (A1), R4.2, SJ4.2, TP1.P$1
ALERT: IC1.7 (ALERT), JP2.5
GND: C1.2, IC1.6 (GND), IC1.11 (GND), IC1.13 (GND), JP2.2, R3.1, R4.1
IN+: IC1.1 (IN+), IC1.2 (IN+), IC1.3 (IN+), JP2.7, SJ1.1, X1.P$3 (1)
IN-: IC1.14 (IN-), IC1.15 (IN-), IC1.16 (IN-), JP2.8, X1.P$4 (2)
SCL: IC1.9 (SCL), JP2.3, R2.2
SDA: IC1.8 (SDA), JP2.4, R1.2
VBUS: IC1.12 (VBUS), JP2.6, SJ1.2
VCC: C1.1, IC1.10 (VS), JP2.1, R1.1, R2.1, SJ3.1, SJ4.1

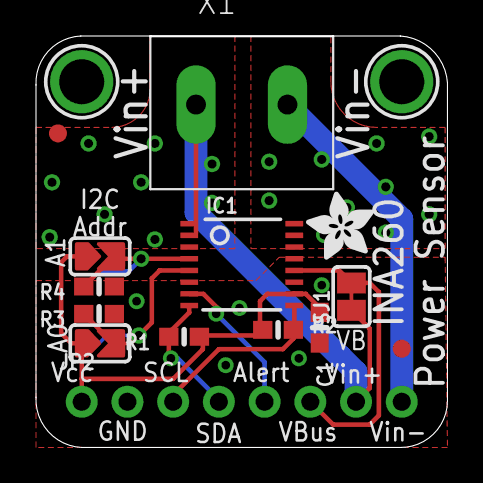
[picture p36: board Adafruit INA260.brd from above]

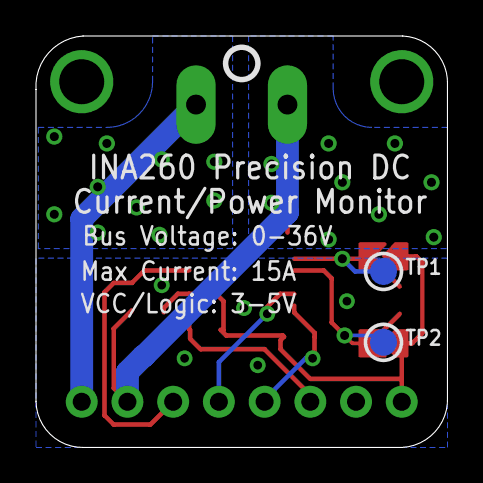
[picture p37: board Adafruit INA260.brd from below]

Board: 2 copper layers, 22.9 x 22.9 mm, 19 parts (3 on the bottom side), 10 nets.

Other parts of the board:
U$1: ADAFRUIT_3.5MM
U$6: PCBFEAT-REV-040
