lpozdneev/team-buzz/Schematics/HyTech HV Board/HV Board rev12.brd

## EAGLE design Schematics/HyTech HV Board/HV Board rev12.brd (2021-02-03, an earlier design)

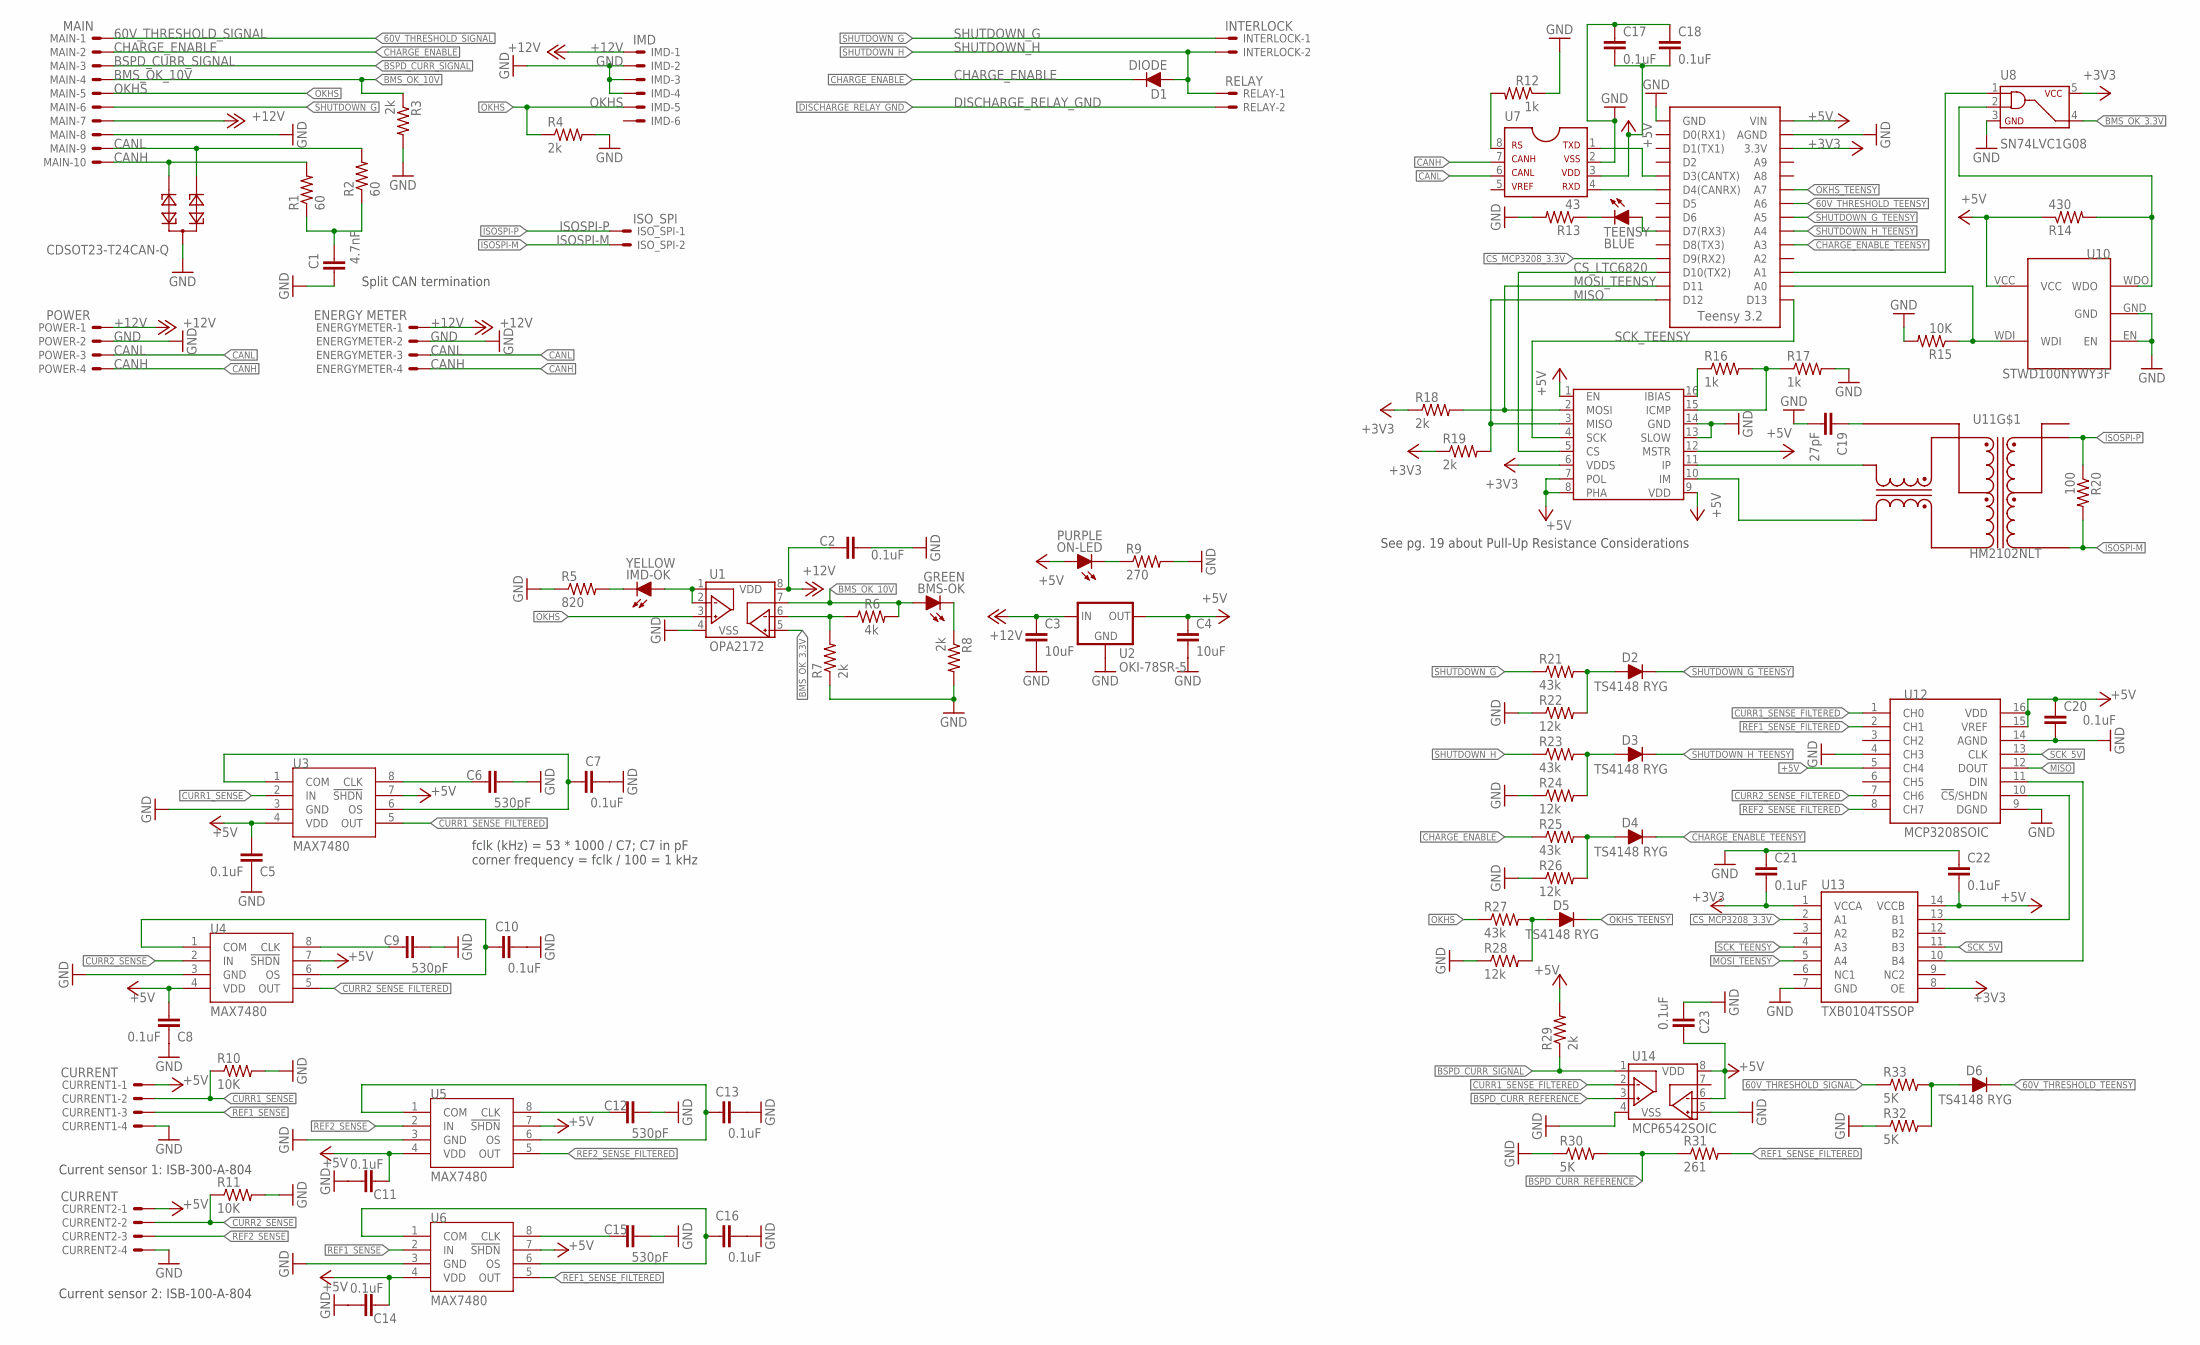
[picture p38: schematic HV Board rev12.sch, sheet 1, GLV Systems (Main IO, LEDs, Power, Current Sensors, AIRs, a…]

Parts:
BMS-OK: GREEN; LED-805
C1: 4.7nF; 0603-CAP; TOLERANCE 5%; VOLTAGE 50V
C2, C5, C7, C8, C10, C11, C13, C14, C16, C17, C18, C20, C21, C22, C23: 0.1uF; 0603-CAP; TOLERANCE 5%; VOLTAGE 10V
C3, C4: 10uF; 0603-CAP; TOLERANCE 5%; VOLTAGE 25V
C6, C9, C12, C15: 530pF; 0603-CAP; TOLERANCE 1%; VOLTAGE 10V
C19: 27pF; 0603-CAP; TOLERANCE 5%; VOLTAGE 10V
CURRENT1, CURRENT2: CURRENT; NANO-FIT_VERTICAL-4
D1: DIODE; DO-41
D2, D3, D4, D5, D6: TS4148 RYG; 0805_D
ENERGYMETER: ENERGY METER; NANO-FIT_VERTICAL-4
IMD: IMD; NANO-FIT_VERTICAL-6
IMD-OK: YELLOW; LED-805
INTERLOCK: INTERLOCK; NANO-FIT_VERTICAL-2
ISO_SPI: ISO_SPI; NANO-FIT_VERTICAL-2
MAIN: MAIN; NANO-FIT_VERTICAL-10
ON-LED: PURPLE; LED-805
POWER: POWER; NANO-FIT_VERTICAL-4
R1, R2: 60; 0603-RES; TOLERANCE 1%
R3, R4, R7, R8, R18, R19, R29: 2k; 0603-RES; TOLERANCE 1%
R5: 820; 0603-RES; TOLERANCE 1%
R6: 4k; 0603-RES; TOLERANCE 1%
R9: 270; 0603-RES; TOLERANCE 1%
R10, R11, R15: 10K; 0603-RES; TOLERANCE 1%
R12, R16, R17: 1k; 0603-RES; TOLERANCE 1%
R13: 43; 0603-RES; TOLERANCE 1%
R14: 430; 0603-RES; TOLERANCE 1%
R20: 100; 0603-RES; TOLERANCE 1%
R21, R23, R25, R27: 43k; 0603-RES; TOLERANCE 1%
R22, R24, R26, R28: 12k; 0603-RES; TOLERANCE 1%
R30, R32, R33: 5K; 0603-RES; TOLERANCE 1%
R31: 261; 0603-RES; TOLERANCE 1%
RELAY: RELAY; NANO-FIT_VERTICAL-2
TEENSY: BLUE; LED-805
TEENSY3.2: TEENSY_3.2_SIMPLE
U1: OPA2172; SOIC-08
U2: OKI-78SR-5; OKI-78SR
U3, U4, U5, U6: MAX7480; SOIC-08
U7: MCP2551; SOIC-08
U8: SN74LVC1G08; SOT-23-5
U9: LTC6820; MSOP-16
U10: STWD100NYWY3F; SOT23-5
U11: HM2102NLT
U12: MCP3208SOIC; SOIC-16
U13: TXB0104TSSOP; TSSOP-14
U14: MCP6542SOIC; SOIC-08
U18: CDSOT23-T24CAN-Q; SOT23

Connections:
60V_THRESHOLD_SIGNAL: MAIN.P$1, R33.1; also elsewhere on the board
60V_THRESHOLD_TEENSY: D6.C, TEENSY3.2.A6
+3V3: C21.1, R18.1, R19.1, TEENSY3.2.3.3V, U8.5, U9.6 (VDDS), U13.1 (VCCA), U13.8 (OE)
+5V: C4.1, C5.1, C8.1, C11.1, C14.1, C17.1, C18.1, C20.1, C22.1, C23.1, CURRENT1.P$1, CURRENT2.P$1, ON-LED.A, R14.1, R29.2, TEENSY3.2.VIN, U2.3 (OUT), U3.4 (VDD), U3.7 (!SHDN), U4.4 (VDD), U4.7 (!SHDN), U5.4 (VDD), U5.7 (!SHDN), U6.4 (VDD), U6.7 (!SHDN), U7.3, U9.1 (EN), U9.7 (POL), U9.8 (PHA), U9.9 (VDD), U9.12 (MSTR), U10.VCC, U12.5 (CH4), U12.15 (VREF), U12.16 (VDD), U13.14 (VCCB), U14.6 (VINB-), U14.8 (VDD); also elsewhere on the board
+12V: C2.1, C3.1, ENERGYMETER.P$1, IMD.P$1, MAIN.P$7, POWER.P$1, U1.8 (VDD), U2.1 (IN); also elsewhere on the board
BMS_OK_3.3V: U1.5 (VINB+), U8.4
BMS_OK_10V: BMS-OK.A, MAIN.P$4, R3.1, R6.2, U1.7 (VOUTB)
BSPD_CURR_REFERENCE: R30.2, R31.1, U14.3 (VINA+)
BSPD_CURR_SIGNAL: MAIN.P$3, R29.1, U14.1 (VOUTA)
CANH: ENERGYMETER.P$4, MAIN.P$10, POWER.P$4, R1.2, U7.7, U18.2
CANL: ENERGYMETER.P$3, MAIN.P$9, POWER.P$3, R2.2, U7.6, U18.1
CHARGE_ENABLE: D1.C, MAIN.P$2, R25.1
CHARGE_ENABLE_TEENSY: D4.C, TEENSY3.2.A3
CS_LTC6820: TEENSY3.2.D10(TX2), U9.5 (CS)
CS_MCP3208_3.3V: TEENSY3.2.D9(RX2), U13.2 (A1)
CURR1_SENSE: CURRENT1.P$2, R10.1, U3.2 (IN)
CURR1_SENSE_FILTERED: U3.5 (OUT), U12.1 (CH0), U14.2 (VINA-)
CURR2_SENSE: CURRENT2.P$2, R11.1, U4.2 (IN)
CURR2_SENSE_FILTERED: U4.5 (OUT), U12.7 (CH6)
DISCHARGE_RELAY_GND: RELAY.P$2; also elsewhere on the board
GND: C1.1, C2.2, C3.2, C4.2, C5.2, C6.2, C7.2, C8.2, C9.2, C10.2, C11.2, C12.2, C13.2, C14.2, C15.2, C16.2, C17.2, C18.2, C19.2, C20.2, C21.2, C22.2, C23.2, CURRENT1.P$4, CURRENT2.P$4, ENERGYMETER.P$2, IMD.P$2, IMD.P$3, IMD.P$4, MAIN.P$8, POWER.P$2, R3.2, R4.2, R5.1, R7.1, R8.2, R9.2, R10.2, R11.2, R12.1, R13.2, R15.2, R17.2, R22.1, R24.1, R26.1, R28.1, R30.1, R32.1, TEENSY3.2.AGND, TEENSY3.2.GND, U1.4 (VSS), U2.2 (GND), U3.3 (GND), U4.3 (GND), U5.3 (GND), U6.3 (GND), U7.2, U8.3, U9.13 (SLOW), U9.14 (GND), U10.EN, U10.GND, U12.4 (CH3), U12.9 (DGND), U12.14 (AGND), U13.7 (GND), U14.4 (VSS), U14.5 (VINB+), U18.3; also elsewhere on the board
IM: U9.10 (IM), U11.P$10 (TD-)
IP: U9.11 (IP), U11.P$12 (TD+)
ISOSPI-M: ISO_SPI.P$2, R20.2, U11.P$3 (MX-)
ISOSPI-P: ISO_SPI.P$1, R20.1, U11.P$1 (MX+)
MISO: R19.2, TEENSY3.2.D12, U9.3 (MISO), U12.12 (DOUT)
MOSI_5V: U12.11 (DIN), U13.10 (B4)
MOSI_TEENSY: R18.2, TEENSY3.2.D11, U9.2 (MOSI), U13.5 (A4)
unnamed: C7.1, U3.1 (COM), U3.6 (OS)
unnamed: ON-LED.C, R9.1
unnamed: C6.1, U3.8 (CLK)
unnamed: U12.10 (!CS!/SHDN), U13.13 (B1)
unnamed: D2.A, R21.2, R22.2
unnamed: D4.A, R25.2, R26.2
unnamed: D6.A, R32.2, R33.2
unnamed: C1.2, R1.1, R2.1
unnamed: R6.1, R7.2, U1.6 (VINB-)
unnamed: D3.A, R23.2, R24.2
unnamed: D5.A, R27.2, R28.2
unnamed: TEENSY3.2.D3(CANTX), U7.1
unnamed: R12.2, U7.8
unnamed: R13.1, TEENSY.C
unnamed: R16.1, U9.16 (IBIAS)
unnamed: R16.2, R17.1, U9.15 (ICMP)
unnamed: C19.1, U11.P$11 (TCT)
unnamed: TEENSY3.2.D4(CANRX), U7.4
unnamed: TEENSY.A, TEENSY3.2.D7(RX3)
unnamed: R14.2, U8.2, U10.WDO
unnamed: TEENSY3.2.A1, U8.1
unnamed: IMD-OK.A, U1.1 (VOUTA), U1.2 (VINA-)
unnamed: BMS-OK.C, R8.1
unnamed: IMD-OK.C, R5.2
unnamed: C16.1, U6.1 (COM), U6.6 (OS)
unnamed: C15.1, U6.8 (CLK)
unnamed: R15.1, TEENSY3.2.A0, U10.WDI
unnamed: C10.1, U4.1 (COM), U4.6 (OS)
unnamed: C9.1, U4.8 (CLK)
unnamed: C13.1, U5.1 (COM), U5.6 (OS)
unnamed: C12.1, U5.8 (CLK)
OKHS: IMD.P$5, MAIN.P$5, R4.1, R27.1, U1.3 (VINA+)
OKHS_TEENSY: D5.C, TEENSY3.2.A7
REF1_SENSE: CURRENT1.P$3, U6.2 (IN)
REF1_SENSE_FILTERED: R31.2, U6.5 (OUT), U12.2 (CH1)
REF2_SENSE: CURRENT2.P$3, U5.2 (IN)
REF2_SENSE_FILTERED: U5.5 (OUT), U12.8 (CH7)
SCK_5V: U12.13 (CLK), U13.11 (B3)
SCK_TEENSY: TEENSY3.2.D13, U9.4 (SCK), U13.4 (A3)
SHUTDOWN_G: INTERLOCK.P$1, MAIN.P$6, R21.1
SHUTDOWN_G_TEENSY: D2.C, TEENSY3.2.A5
SHUTDOWN_H: D1.A, INTERLOCK.P$2, R23.1, RELAY.P$1; also elsewhere on the board
SHUTDOWN_H_TEENSY: D3.C, TEENSY3.2.A4

Notes on the sheet:
Current sensor 1: ISB-300-A-804
See pg. 19 about Pull-Up Resistance Considerations
fclk (kHz) = 53 * 1000 / C7; C7 in pF corner frequency = fclk / 100 = 1 kHz
Split CAN termination
Current sensor 2: ISB-100-A-804
