lpozdneev/team-buzz/Schematics/HyTech HV Board/HV Board rev12.brd

## EAGLE design Schematics/HyTech HV Board/HV Board rev12.brd (continued)

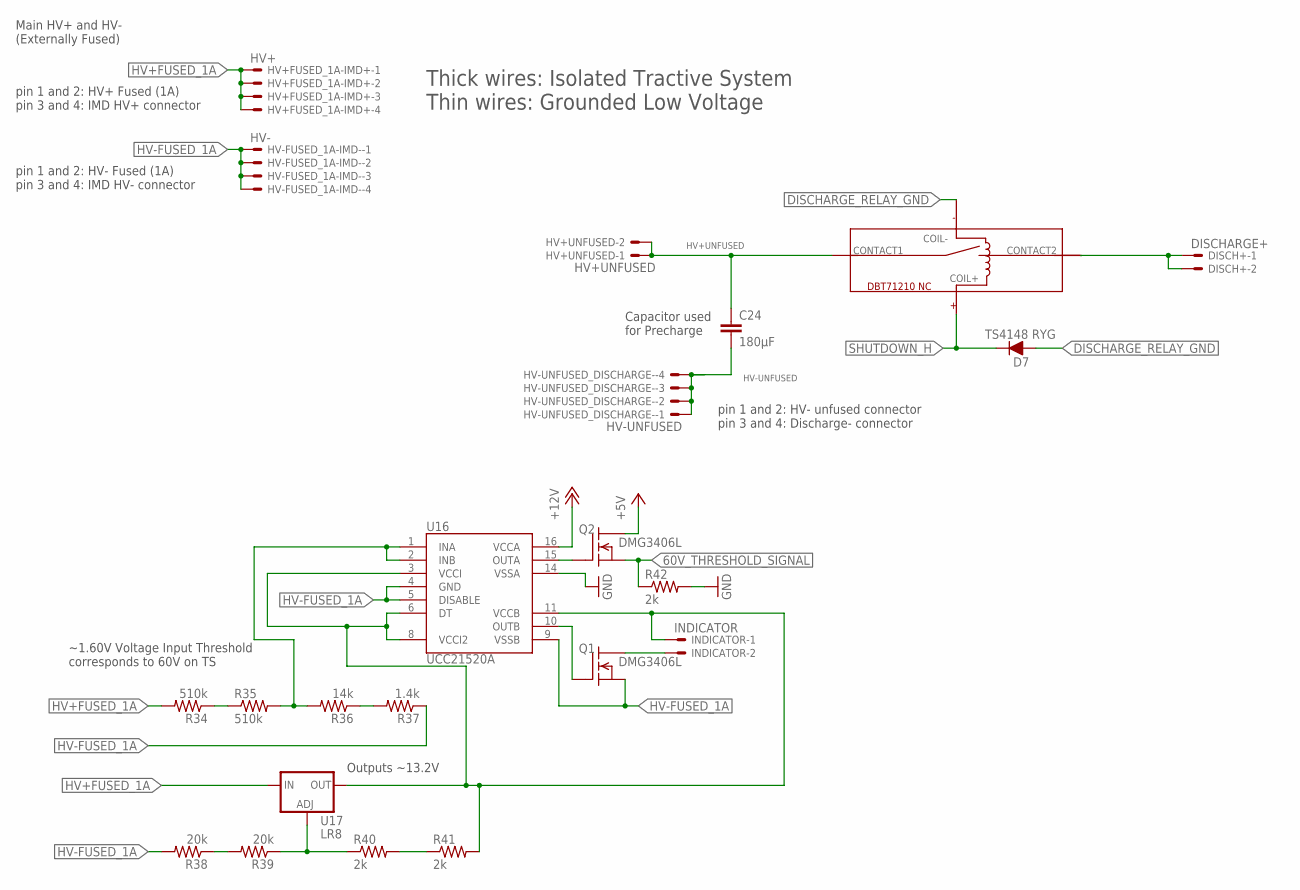
[picture p39: schematic HV Board rev12.sch, sheet 2, HV Systems (Discharge, Precharge, and TSAL/Voltage Indicato…]

Parts:
C24: 180µF; LLS2V221MELZ; TOLERANCE 20%; VOLTAGE 350V
D7: TS4148 RYG; 0805_D
DISCH+: DISCHARGE+; NANO-FIT_VERTICAL-2
HV+FUSED_1A-IMD+: HV+; NANO-FIT_VERTICAL-4
HV+UNFUSED: HV+UNFUSED; NANO-FIT_VERTICAL-2
HV-FUSED_1A-IMD-: HV-; NANO-FIT_VERTICAL-4
HV-UNFUSED_DISCHARGE-: HV-UNFUSED; NANO-FIT_VERTICAL-4
INDICATOR: INDICATOR; NANO-FIT_VERTICAL-2
Q1, Q2: DMG3406L; SOT23
R34, R35: 510k; 0805; TOLERANCE 1%
R36: 14k; 0805; TOLERANCE 1%
R37: 1.4k; 0805; TOLERANCE 1%
R38, R39: 20k; 0805; TOLERANCE 1%
R40, R41: 2k; 0805; TOLERANCE 1%
R42: 2k; 0603-RES; TOLERANCE 1%
U15: DBT71210
U16: UCC21520A; SO16-DW
U17: LR8; TO-252

Connections:
60V_THRESHOLD_SIGNAL: Q2.2 (S), R42.1; also elsewhere on the board
+5V: Q2.3 (D); also elsewhere on the board
+12V: U16.16 (VCCA); also elsewhere on the board
DISCHARGE_RELAY_GND: D7.A, U15.COIL-; also elsewhere on the board
GND: R42.2, U16.14 (VSSA); also elsewhere on the board
HV+FUSED_1A: HV+FUSED_1A-IMD+.P$1, HV+FUSED_1A-IMD+.P$2, HV+FUSED_1A-IMD+.P$3, HV+FUSED_1A-IMD+.P$4, R34.2, U17.1 (IN)
HV+UNFUSED: C24.P$1 (1), HV+UNFUSED.P$1, HV+UNFUSED.P$2, U15.CONTACT1
HV+UNFUSED_FSAE_DISCHARGE: DISCH+.P$1, DISCH+.P$2, U15.CONTACT2
HV-FUSED_1A: HV-FUSED_1A-IMD-.P$1, HV-FUSED_1A-IMD-.P$2, HV-FUSED_1A-IMD-.P$3, HV-FUSED_1A-IMD-.P$4, Q1.2 (S), R37.1, R38.2, U16.4 (GND), U16.5 (DISABLE), U16.9 (VSSB)
HV-UNFUSED: C24.P$2 (2), HV-UNFUSED_DISCHARGE-.P$1, HV-UNFUSED_DISCHARGE-.P$2, HV-UNFUSED_DISCHARGE-.P$3, HV-UNFUSED_DISCHARGE-.P$4
unnamed: INDICATOR.P$2, Q1.3 (D)
unnamed: R34.1, R35.1
unnamed: R39.1, R40.1, U17.3 (ADJ)
unnamed: R35.2, R36.2, U16.1 (INA), U16.2 (INB)
unnamed: R36.1, R37.2
unnamed: Q2.1 (G), U16.15 (OUTA)
unnamed: Q1.1 (G), U16.10 (OUTB)
unnamed: INDICATOR.P$1, R41.2, U16.3 (VCCI), U16.6 (DT), U16.8 (VCCI2), U16.11 (VCCB), U17.2(TAB) (OUT)
unnamed: R40.2, R41.1
unnamed: R38.1, R39.2
SHUTDOWN_H: D7.C, U15.COIL+; also elsewhere on the board

Notes on the sheet:
Main HV+ and HV- (Externally Fused)
Thick wires: Isolated Tractive System Thin wires: Grounded Low Voltage
pin 1 and 2: HV+ Fused (1A) pin 3 and 4: IMD HV+ connector
pin 1 and 2: HV- Fused (1A) pin 3 and 4: IMD HV- connector
Capacitor used for Precharge
pin 1 and 2: HV- unfused connector pin 3 and 4: Discharge- connector
~1.60V Voltage Input Threshold corresponds to 60V on TS
Outputs ~13.2V

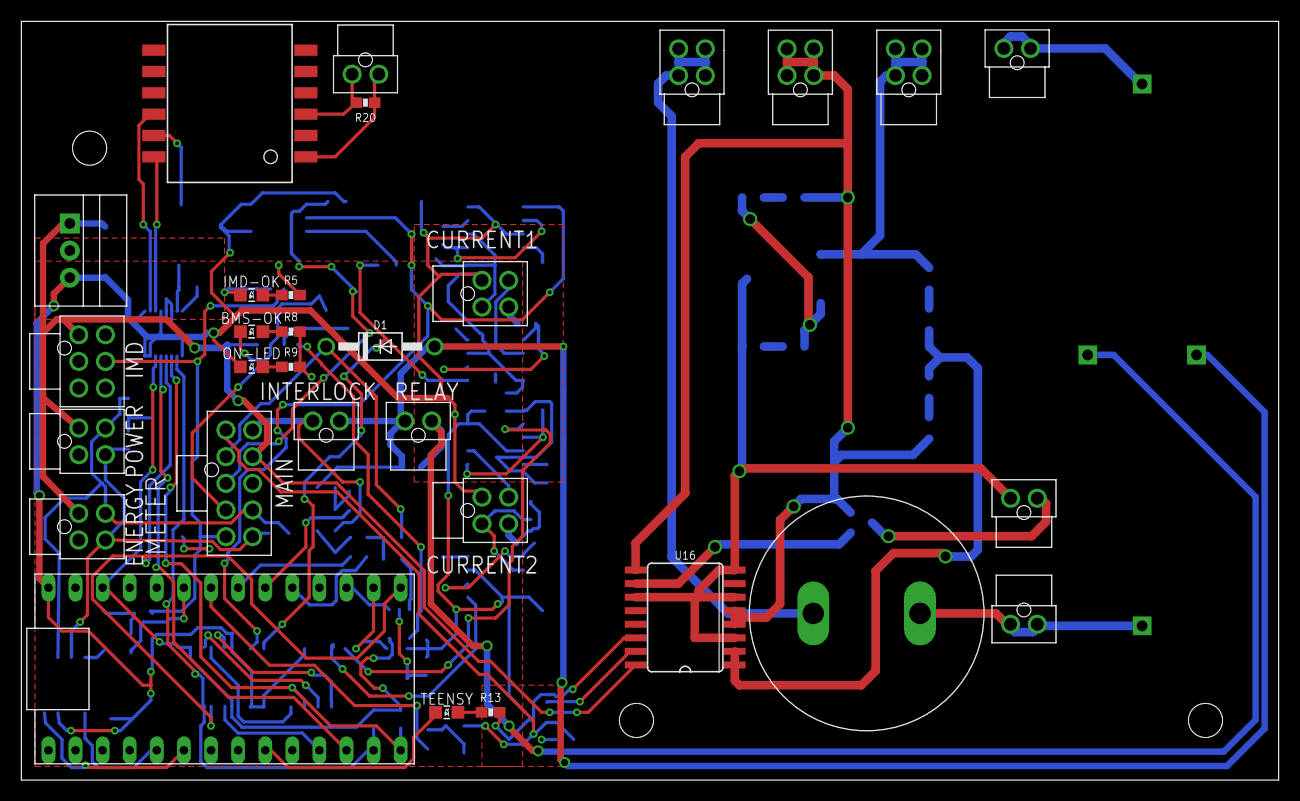
[picture p40: board HV Board rev12.brd from above]

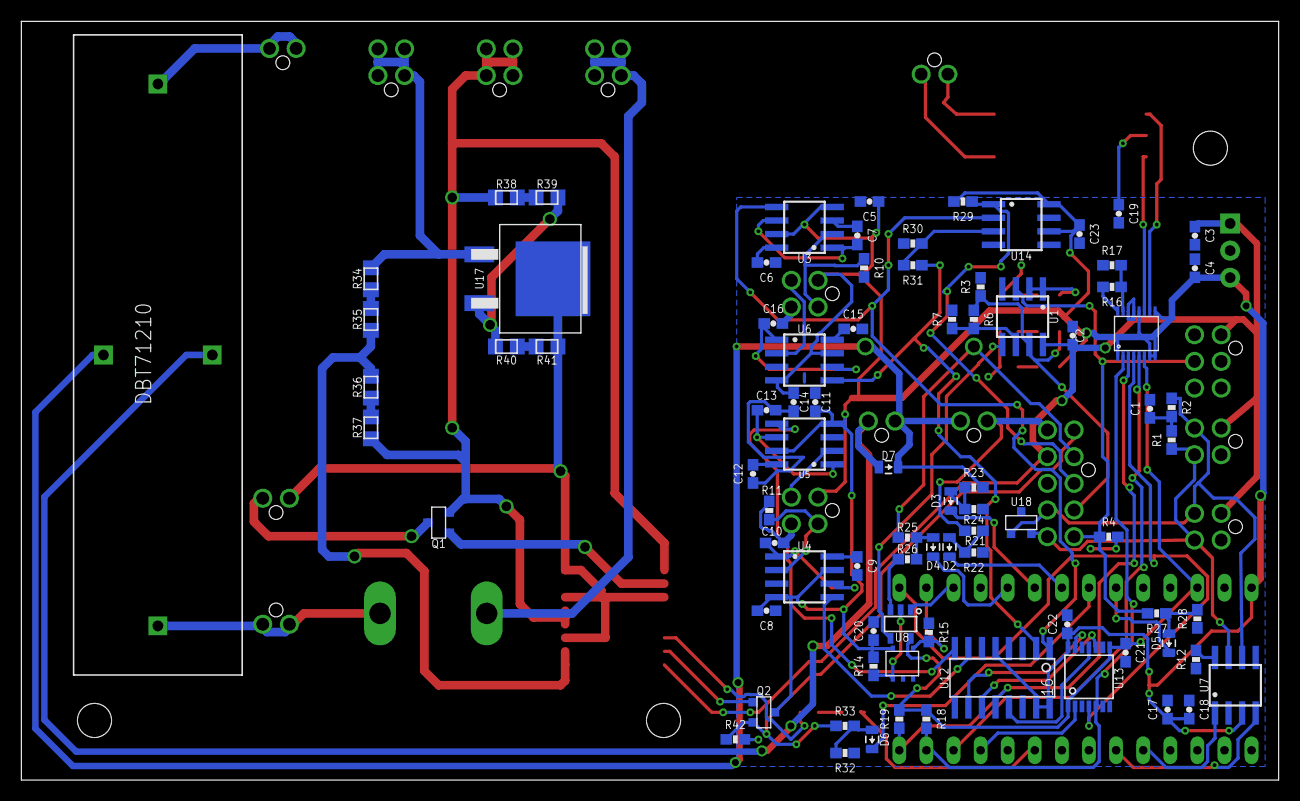
[picture p41: board HV Board rev12.brd from below]

Board: 2 copper layers, 117.9 x 71.1 mm, 113 parts (83 on the bottom side), 86 nets.
