lpozdneev/team-buzz/Schematics/HyTech HV Board/HV Board rev11.brd

## EAGLE design Schematics/HyTech HV Board/HV Board rev11.brd (2021-02-03, an earlier design)

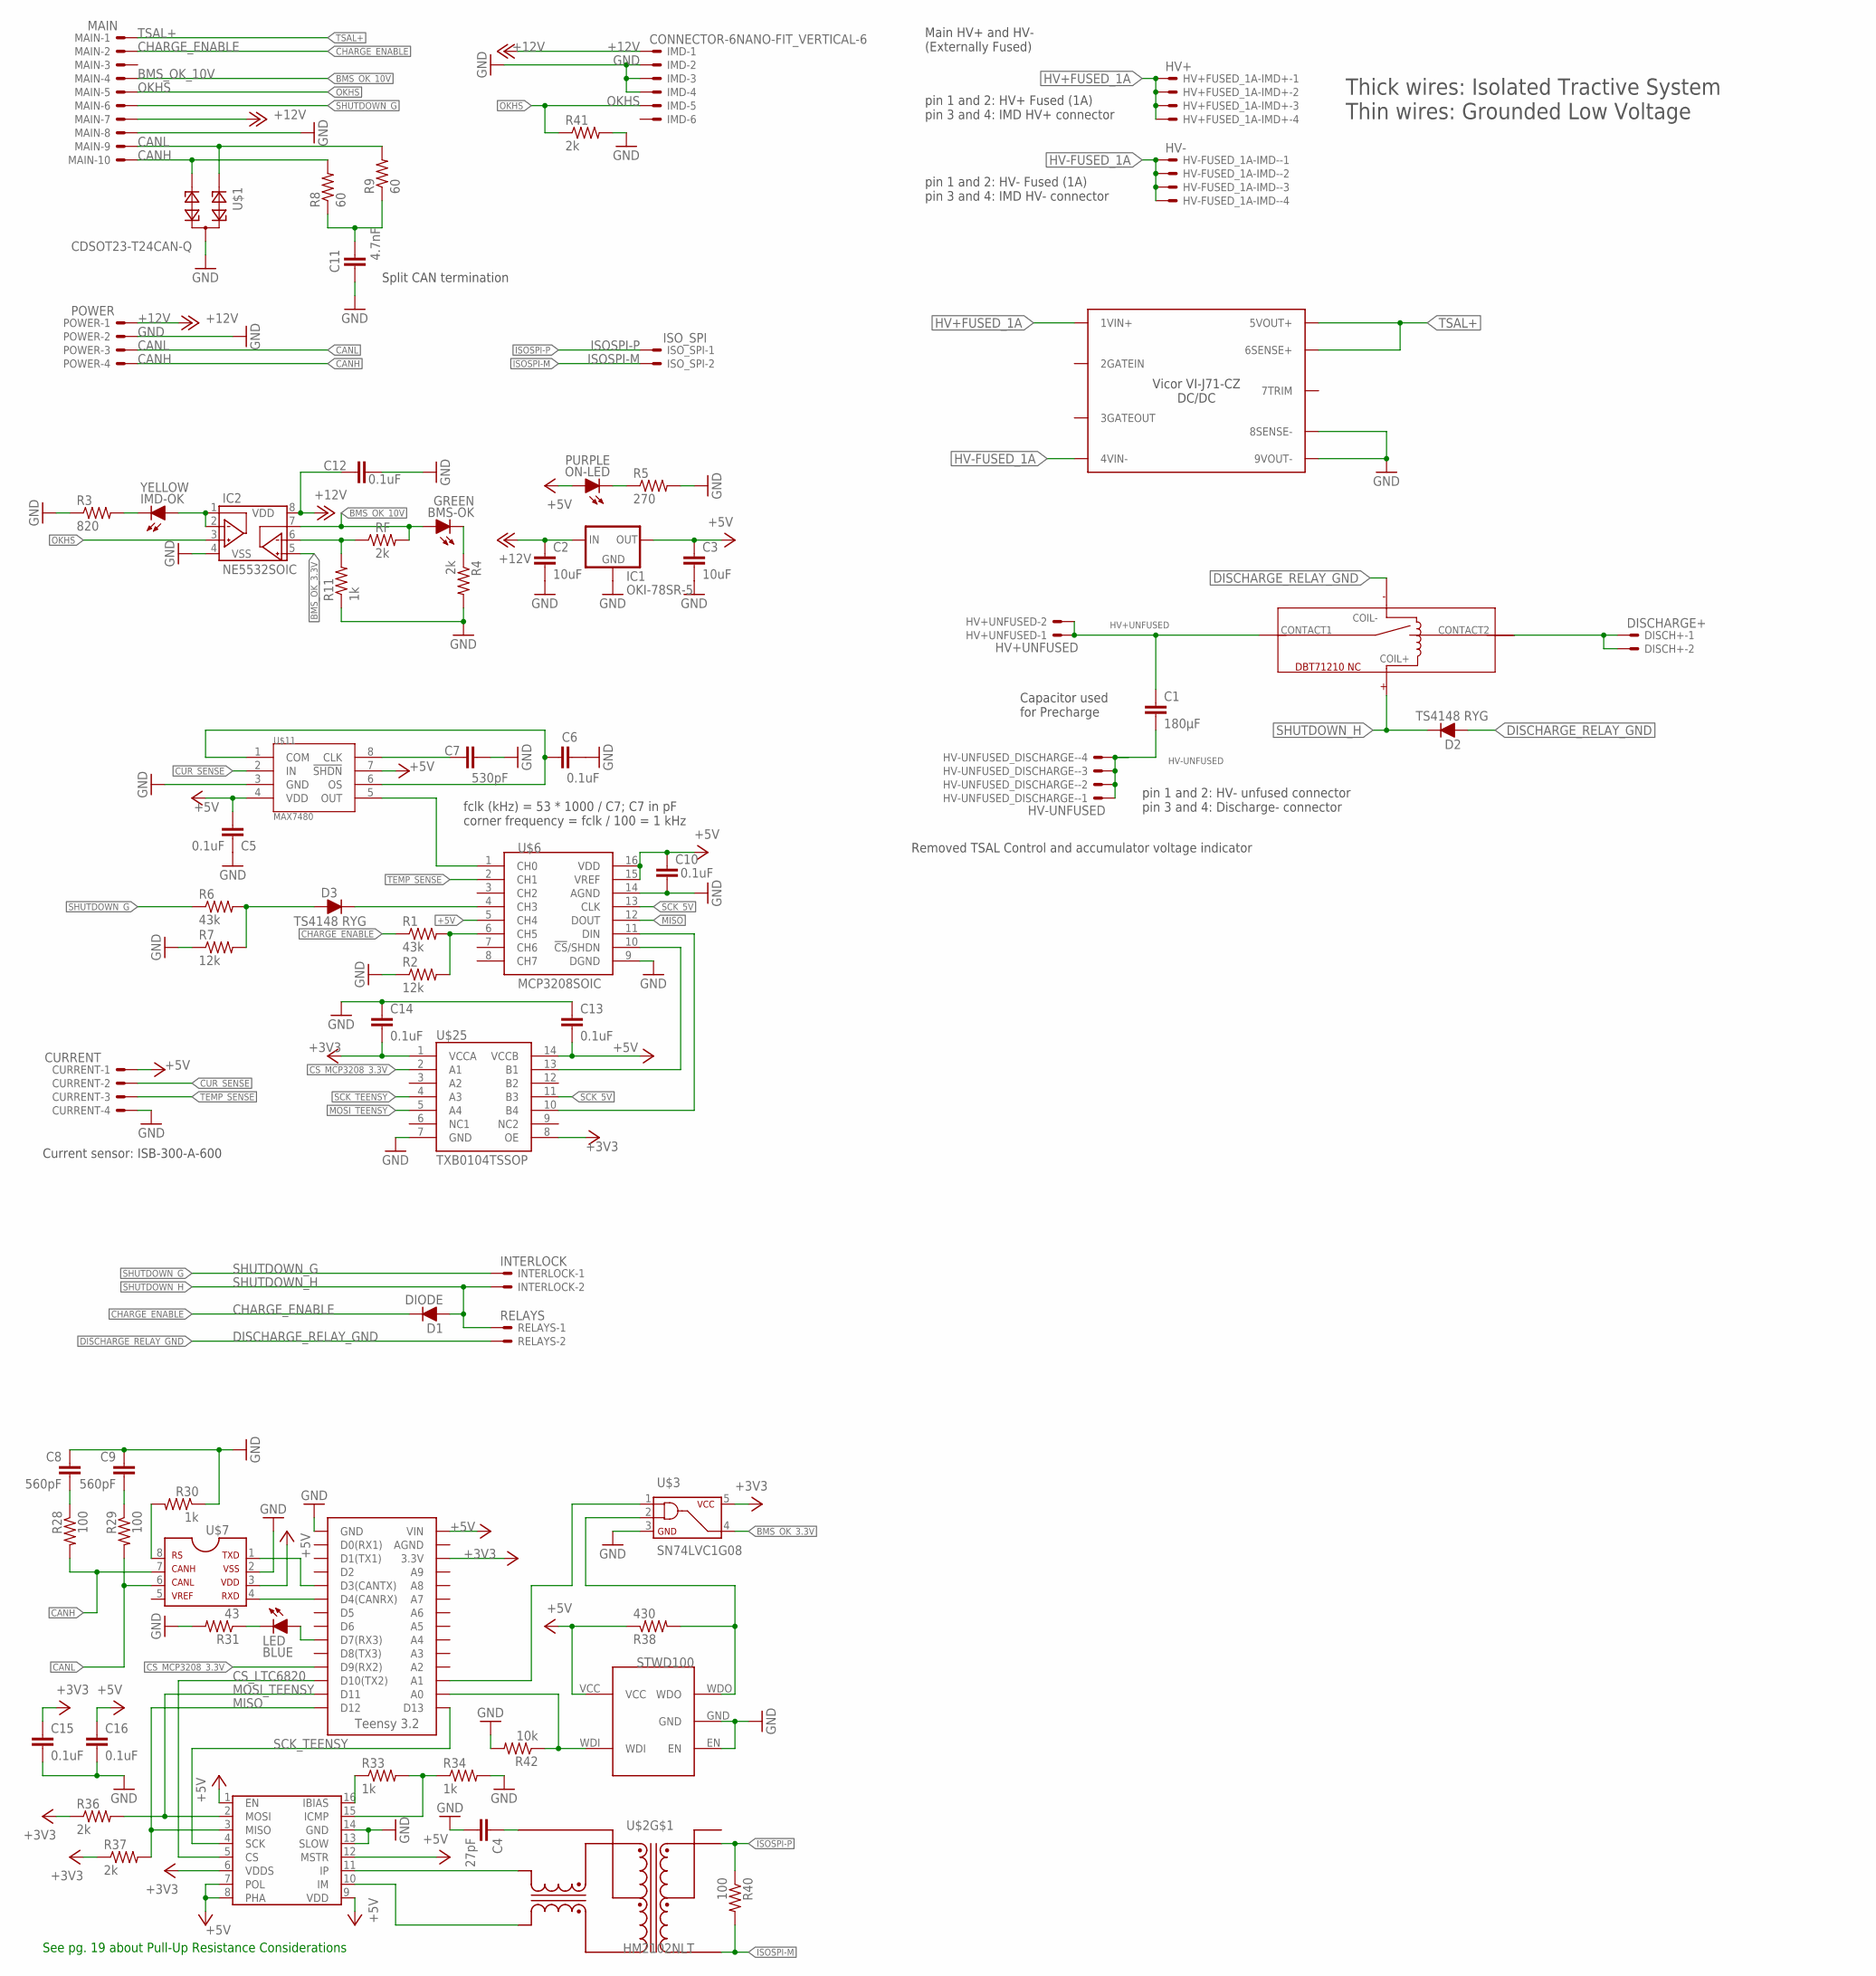
[picture p42: schematic HV Board rev11.sch]

Parts:
BMS-OK: GREEN; LED-805
C1: 180µF; LLS2V221MELZ
C2, C3: 10uF; 0805
C4: 27pF; 0805
C5, C6, C10, C12, C13, C14, C15, C16: 0.1uF; 0805
C7: 530pF; 0805
C8, C9: 560pF; 0805
C11: 4.7nF; 0805
CURRENT: CURRENT; NANO-FIT_VERTICAL-4
D1: DIODE; DO-41
D2, D3: TS4148 RYG; 0805_D
DISCH+: DISCHARGE+; NANO-FIT_VERTICAL-2
HV+FUSED_1A-IMD+: HV+; NANO-FIT_VERTICAL-4
HV+UNFUSED: HV+UNFUSED; NANO-FIT_VERTICAL-2
HV-FUSED_1A-IMD-: HV-; NANO-FIT_VERTICAL-4
HV-UNFUSED_DISCHARGE-: HV-UNFUSED; NANO-FIT_VERTICAL-4
IC1: OKI-78SR-5; OKI-78SR
IC2: NE5532SOIC; SOIC-08
IMD: CONNECTOR-6NANO-FIT_VERTICAL-6; NANO-FIT_VERTICAL-6
IMD-OK: YELLOW; LED-805
INTERLOCK: INTERLOCK; NANO-FIT_VERTICAL-2
ISO_SPI: ISO_SPI; NANO-FIT_VERTICAL-2
LED: BLUE; LED-805
MAIN: MAIN; NANO-FIT_VERTICAL-10
ON-LED: PURPLE; LED-805
POWER: POWER; NANO-FIT_VERTICAL-4
R1, R6: 43k; 0805
R2, R7: 12k; 0805
R3: 820; 0805
R4, R36, R37, R41: 2k; 0805
R5: 270; 0805
R8, R9: 60; 0805
R11, R30, R33, R34: 1k; 0805
R28, R29, R40: 100; 0805
R31: 43; 0805
R38: 430; 0805
R42: 10k; 0805
RELAYS: RELAYS; NANO-FIT_VERTICAL-2
RF: 2k; 0805
U$1: CDSOT23-T24CAN-Q; SOT23
U$2: HM2102NLT
U$3: SN74LVC1G08; SOT-23-5
U$4: DBT71210
U$5: HV_DCDC_VI-J71-CZ
U$6: MCP3208SOIC; SOIC-16
U$7: MCP2551; SOIC-08
U$8: LTC6820; MSOP-16
U$9: TEENSY_3.2_SIMPLE
U$10: STWD100; SOT23-5
U$11: MAX7480; SOIC-08
U$25: TXB0104TSSOP; TSSOP-14

Connections:
+3V3: C14.1, C15.2, R36.1, R37.1, U$3.5, U$8.6 (VDDS), U$9.3.3V, U$25.1 (VCCA), U$25.8 (OE)
+5V: C3.1, C5.1, C10.1, C13.1, C16.2, CURRENT.P$1, IC1.3 (OUT), ON-LED.A, R38.1, U$6.5 (CH4), U$6.15 (VREF), U$6.16 (VDD), U$7.3, U$8.1 (EN), U$8.7 (POL), U$8.8 (PHA), U$8.9 (VDD), U$8.12 (MSTR), U$9.VIN, U$10.VCC, U$11.4 (VDD), U$11.7 (!SHDN), U$25.14 (VCCB)
+12V: C2.1, C12.1, IC1.1 (IN), IC2.8 (VDD), IMD.P$1, MAIN.P$7, POWER.P$1
BMS_OK_3.3V: IC2.5 (VINB+), U$3.4
BMS_OK_10V: BMS-OK.A, IC2.7 (VOUTB), MAIN.P$4, RF.2
CANH: MAIN.P$10, POWER.P$4, R8.2, R28.2, U$1.2, U$7.7
CANL: MAIN.P$9, POWER.P$3, R9.2, R29.2, U$1.1, U$7.6
CHARGE_ENABLE: D1.C, MAIN.P$2, R1.1
CS_LTC6820: U$8.5 (CS), U$9.D10(TX2)
CS_MCP3208_3.3V: U$9.D9(RX2), U$25.2 (A1)
CUR_SENSE: CURRENT.P$2, U$11.2 (IN)
DISCHARGE_RELAY_GND: D2.A, RELAYS.P$2, U$4.COIL-
GND: C2.2, C3.2, C4.2, C5.2, C6.2, C7.2, C8.1, C9.1, C10.2, C11.1, C12.2, C13.2, C14.2, C15.1, C16.1, CURRENT.P$4, IC1.2 (GND), IC2.4 (VSS), IMD.P$2, IMD.P$3, IMD.P$4, MAIN.P$8, POWER.P$2, R2.1, R3.1, R4.2, R5.2, R7.1, R11.1, R30.1, R31.2, R34.2, R41.2, R42.2, U$1.3, U$3.3, U$5.8SENSE-, U$5.9VOUT-, U$6.9 (DGND), U$6.14 (AGND), U$7.2, U$8.13 (SLOW), U$8.14 (GND), U$9.GND, U$10.EN, U$10.GND, U$11.3 (GND), U$25.7 (GND)
HV+FUSED_1A: HV+FUSED_1A-IMD+.P$1, HV+FUSED_1A-IMD+.P$2, HV+FUSED_1A-IMD+.P$3, HV+FUSED_1A-IMD+.P$4, U$5.1VIN+
HV+UNFUSED: C1.P$1 (1), HV+UNFUSED.P$1, HV+UNFUSED.P$2, U$4.CONTACT1
HV+UNFUSED_FSAE_DISCHARGE: DISCH+.P$1, DISCH+.P$2, U$4.CONTACT2
HV-FUSED_1A: HV-FUSED_1A-IMD-.P$1, HV-FUSED_1A-IMD-.P$2, HV-FUSED_1A-IMD-.P$3, HV-FUSED_1A-IMD-.P$4, U$5.4VIN-
HV-UNFUSED: C1.P$2 (2), HV-UNFUSED_DISCHARGE-.P$1, HV-UNFUSED_DISCHARGE-.P$2, HV-UNFUSED_DISCHARGE-.P$3, HV-UNFUSED_DISCHARGE-.P$4
IM: U$2.P$10 (TD-), U$8.10 (IM)
IP: U$2.P$12 (TD+), U$8.11 (IP)
ISOSPI-M: ISO_SPI.P$2, R40.2, U$2.P$3 (MX-)
ISOSPI-P: ISO_SPI.P$1, R40.1, U$2.P$1 (MX+)
MISO: R37.2, U$6.12 (DOUT), U$8.3 (MISO), U$9.D12
MOSI_5V: U$6.11 (DIN), U$25.10 (B4)
MOSI_TEENSY: R36.2, U$8.2 (MOSI), U$9.D11, U$25.5 (A4)
unnamed: U$6.1 (CH0), U$11.5 (OUT)
unnamed: C6.1, U$11.1 (COM), U$11.6 (OS)
unnamed: ON-LED.C, R5.1
unnamed: C7.1, U$11.8 (CLK)
unnamed: U$6.10 (!CS!/SHDN), U$25.13 (B1)
unnamed: D3.A, R6.2, R7.2
unnamed: D3.C, U$6.4 (CH3)
unnamed: C11.2, R8.1, R9.1
unnamed: IC2.6 (VINB-), R11.2, RF.1
unnamed: R1.2, R2.2, U$6.6 (CH5)
unnamed: U$7.1, U$9.D3(CANTX)
unnamed: R30.2, U$7.8
unnamed: C8.2, R28.1
unnamed: C9.2, R29.1
unnamed: LED.C, R31.1
unnamed: R33.1, U$8.16 (IBIAS)
unnamed: R33.2, R34.1, U$8.15 (ICMP)
unnamed: C4.1, U$2.P$11 (TCT)
unnamed: U$7.4, U$9.D4(CANRX)
unnamed: LED.A, U$9.D7(RX3)
unnamed: R38.2, U$3.2, U$10.WDO
unnamed: U$3.1, U$9.A1
unnamed: IC2.1 (VOUTA), IC2.2 (VINA-), IMD-OK.A
unnamed: BMS-OK.C, R4.1
unnamed: IMD-OK.C, R3.2
unnamed: R42.1, U$9.A0, U$10.WDI
OKHS: IC2.3 (VINA+), IMD.P$5, MAIN.P$5, R41.1
SCK_5V: U$6.13 (CLK), U$25.11 (B3)
SCK_TEENSY: U$8.4 (SCK), U$9.D13, U$25.4 (A3)
SHUTDOWN_G: INTERLOCK.P$1, MAIN.P$6, R6.1
SHUTDOWN_H: D1.A, D2.C, INTERLOCK.P$2, RELAYS.P$1, U$4.COIL+
TEMP_SENSE: CURRENT.P$3, U$6.2 (CH1)
TSAL+: MAIN.P$1, U$5.5VOUT+, U$5.6SENSE+

Notes on the sheet:
Current sensor: ISB-300-A-600
Main HV+ and HV- (Externally Fused)
Thick wires: Isolated Tractive System Thin wires: Grounded Low Voltage
See pg. 19 about Pull-Up Resistance Considerations
Capacitor used for Precharge
Removed TSAL Control and accumulator voltage indicator
pin 1 and 2: HV+ Fused (1A) pin 3 and 4: IMD HV+ connector
pin 1 and 2: HV- Fused (1A) pin 3 and 4: IMD HV- connector
pin 1 and 2: HV- unfused connector pin 3 and 4: Discharge- connector
fclk (kHz) = 53 * 1000 / C7; C7 in pF corner frequency = fclk / 100 = 1 kHz
Split CAN termination

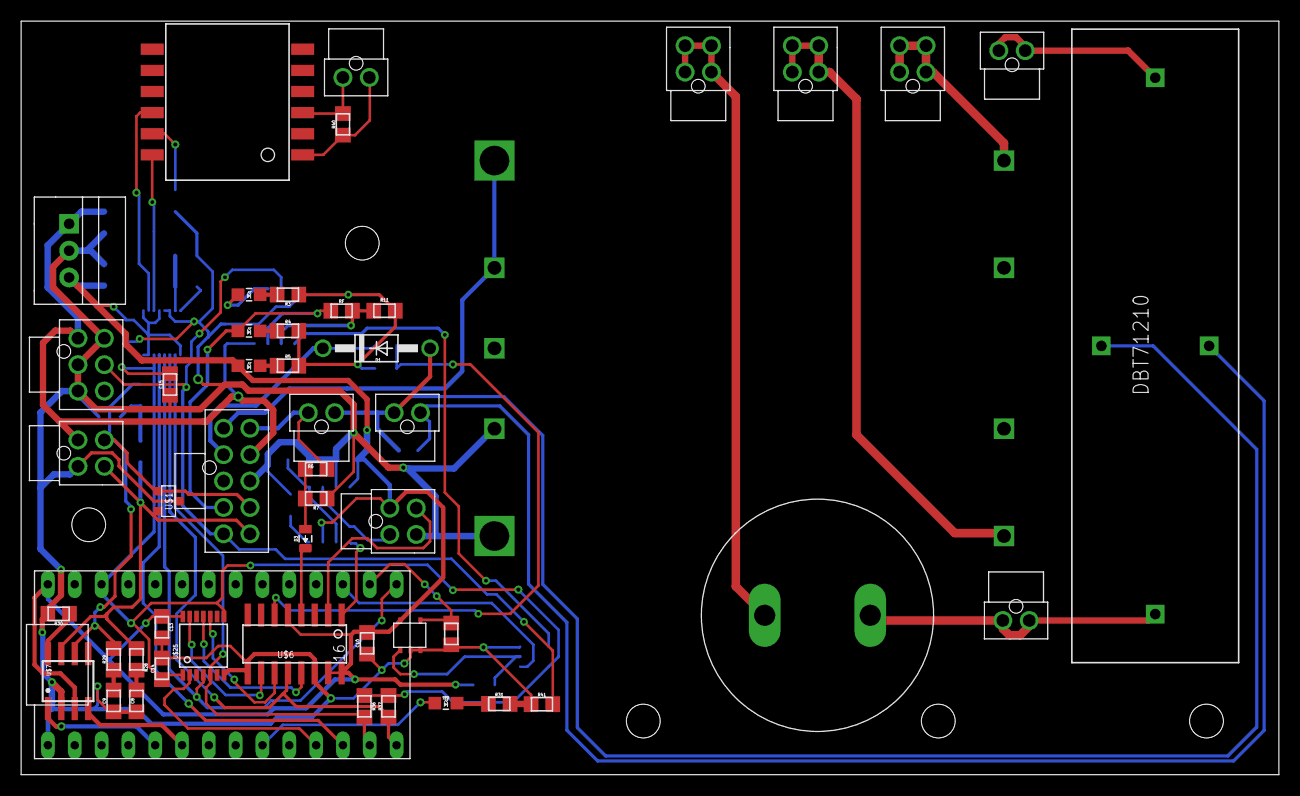
[picture p43: board HV Board rev11.brd from above]

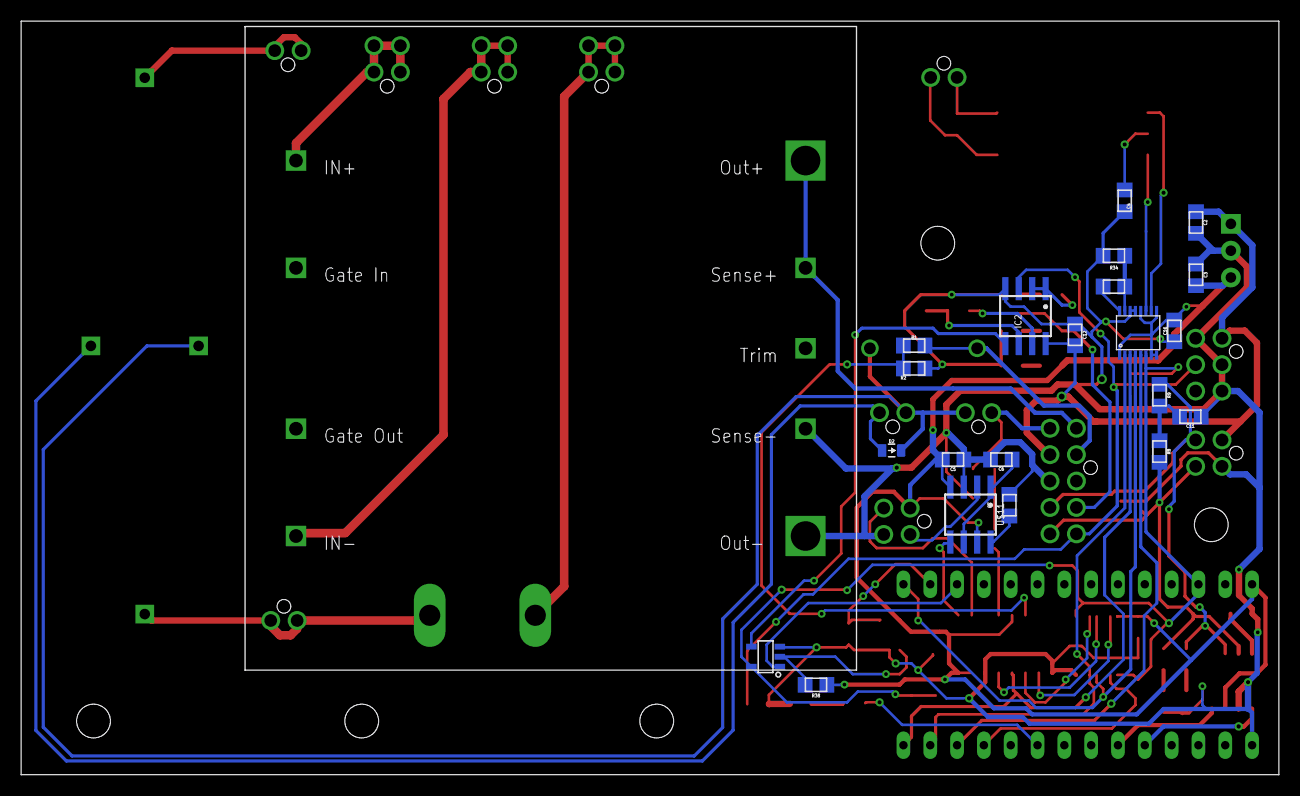
[picture p44: board HV Board rev11.brd from below]

Board: 2 copper layers, 119.1 x 71.4 mm, 72 parts (22 on the bottom side), 58 nets.
