lpozdneev/team-buzz/Schematics/HyTech HV Board/HV Board rev13.brd

## EAGLE design Schematics/HyTech HV Board/HV Board rev13.brd (2021-02-03)

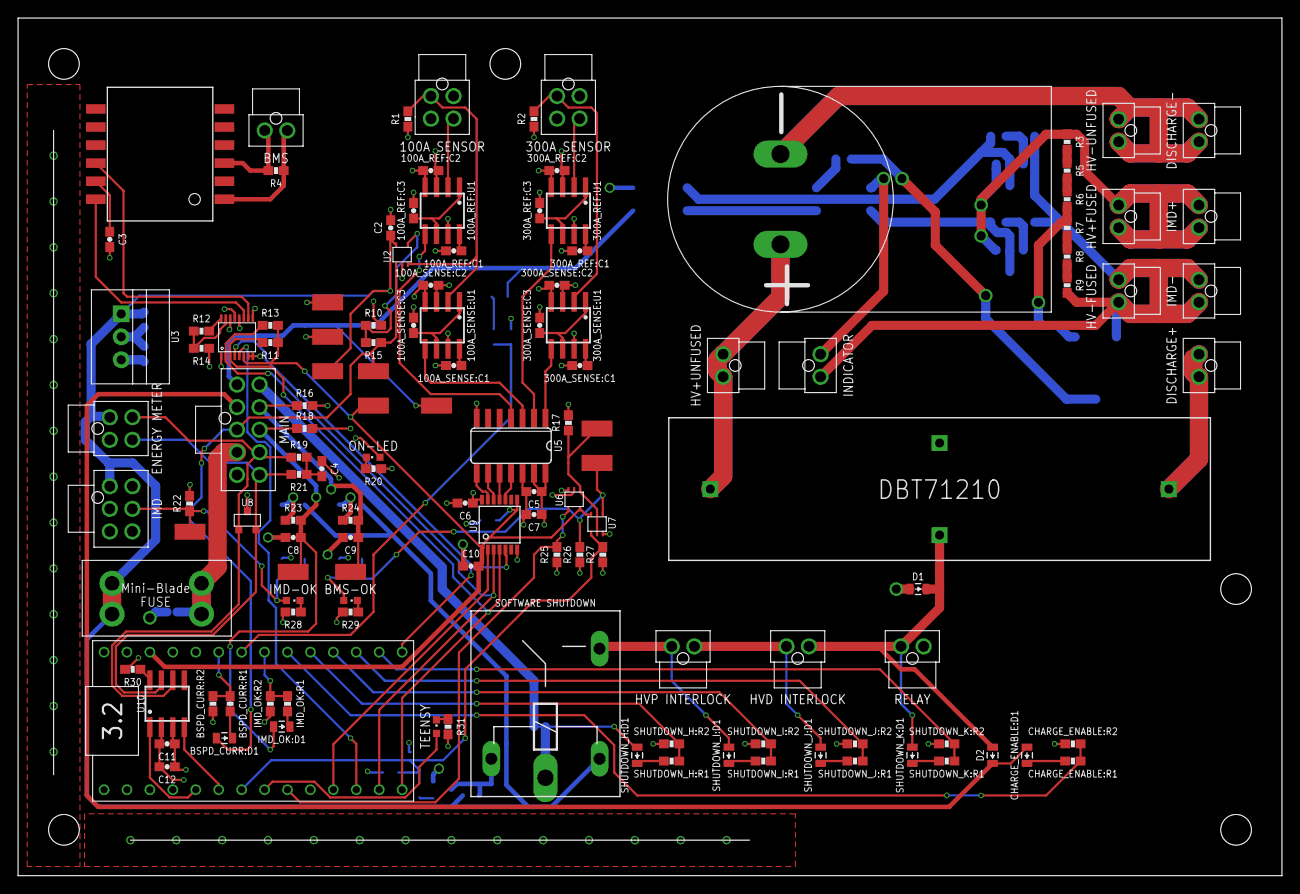
[picture p45: board HV Board rev13.brd from above]

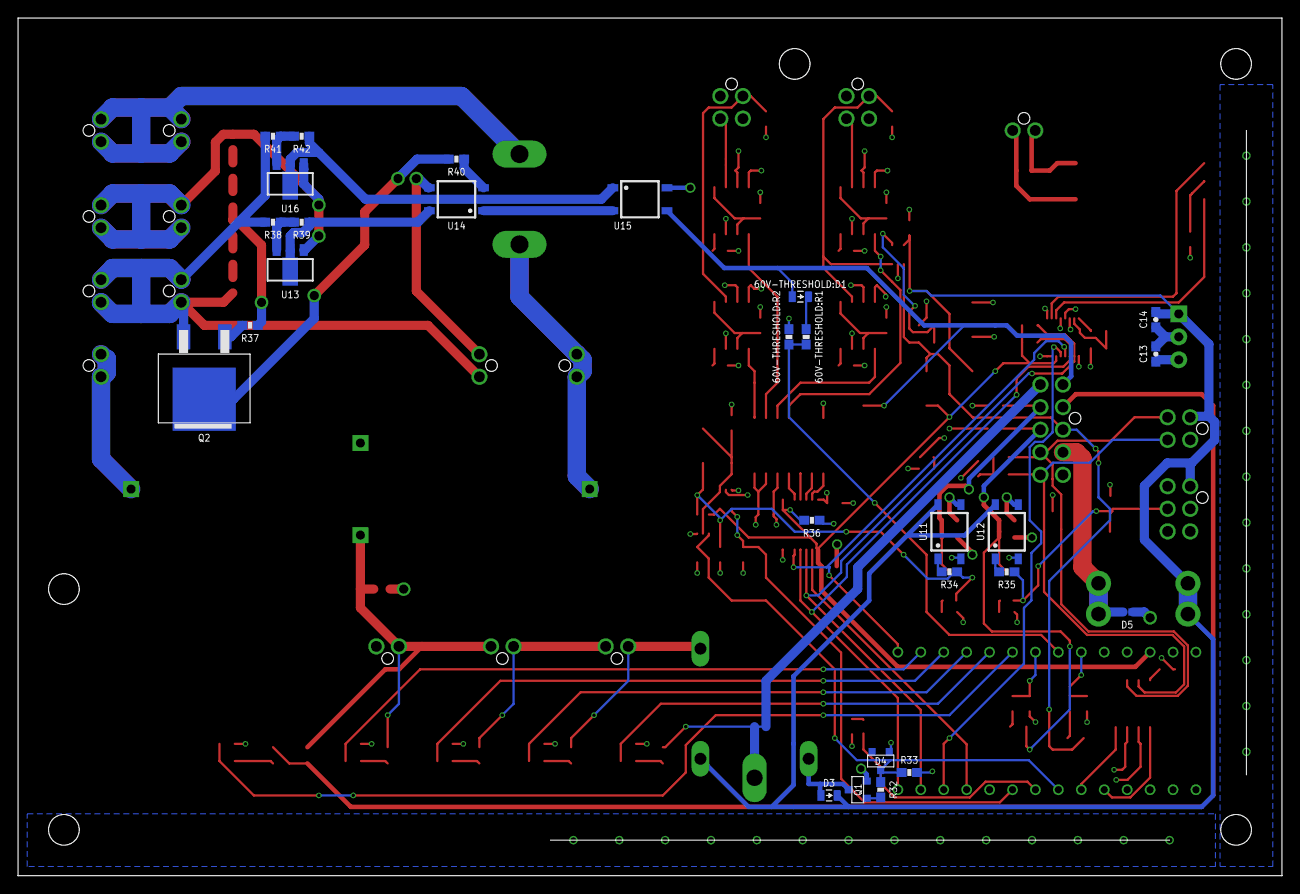
[picture p46: board HV Board rev13.brd from below]

Board: 4 copper layers, 140.0 x 95.0 mm, 161 parts (27 on the bottom side), 104 nets.

Parts:
60V-THRESHOLD:D1: TS4148 RYG; 0805_D
60V-THRESHOLD:R1: 12k; 0603-RES
60V-THRESHOLD:R2: 10k; 0603-RES
100A_REF:C1, 100A_SENSE:C1, 300A_REF:C1, 300A_SENSE:C1: 530pF; 0603-CAP
100A_REF:C2, 100A_REF:C3, 100A_SENSE:C2, 100A_SENSE:C3, 300A_REF:C2, 300A_REF:C3, 300A_SENSE:C2, 300A_SENSE:C3: 0.1uF; 0603-CAP
100A_REF:U1, 100A_SENSE:U1, 300A_REF:U1, 300A_SENSE:U1: MAX7480; SOIC-08
$$U$1, $$U$2: M3_MOUNTING
$$U$12: DBT71210
BMS-OK: GREEN; LED-603
BOARDFUSE: 2A; MINI-BLADE_FUSE_HOLDER
BSPD_CURR:D1: TS4148 RYG; 0805_D
BSPD_CURR:R1: 12K; 0603-RES
BSPD_CURR:R2: 43K; 0603-RES
C1: 180uF; LLS2V181MELA
C2, C5, C6, C8, C9, C10, C11: 0.1uF; 0603-CAP
C3: 27pF; 0603-CAP
C4: 4.7nF; 0603-CAP
C7, C12: 1uF; 0603-CAP
C13, C14: 10uF; 0603-CAP
CHARGE_ENABLE:D1: TS4148 RYG; 0805_D
CHARGE_ENABLE:R1: 12K; 0603-RES
CHARGE_ENABLE:R2: 43K; 0603-RES
CURRENT1: 100A SENSOR; NANO-FIT_VERTICAL-4
CURRENT2: 300A SENSOR; NANO-FIT_VERTICAL-4
D1, D2, D3: TS4148 RYG; 0805_D
D4: MMBZ5246BLT1G; SOT23
D5: TVS_DIODE; U-DFN1608-2
DISCHARGE+: DISCHARGE+; NANO-FIT_VERTICAL-2
DISCHARGE-: DISCHARGE-; NANO-FIT_VERTICAL-2
ENERGYMETER: ENERGY METER; NANO-FIT_VERTICAL-4
HV+FUSED: HV+FUSED; NANO-FIT_VERTICAL-2
HV+UNFUSED: HV+UNFUSED; NANO-FIT_VERTICAL-2
HV-FUSED: HV-FUSED; NANO-FIT_VERTICAL-2
HV-UNFUSED: HV-UNFUSED; NANO-FIT_VERTICAL-2
IMD: IMD; NANO-FIT_VERTICAL-6
IMD+: IMD+; NANO-FIT_VERTICAL-2
IMD-: IMD-; NANO-FIT_VERTICAL-2
IMD-OK: YELLOW; LED-603
IMD_OK:D1: TS4148 RYG; 0805_D
IMD_OK:R1: 12K; 0603-RES
IMD_OK:R2: 43K; 0603-RES
INDICATOR1: INDICATOR; NANO-FIT_VERTICAL-2
INTERLOCK1: HVP INTERLOCK; NANO-FIT_VERTICAL-2
INTERLOCK2: HVD INTERLOCK; NANO-FIT_VERTICAL-2
ISOSPI: BMS; NANO-FIT_VERTICAL-2
MAIN: MAIN; NANO-FIT_VERTICAL-10
ON-LED: BLUE; LED-603
Q1: DMG3406L; SOT23
Q2: AOD1N60; TO-252
R1, R2, R25: 10K; 0603-RES
R3, R5, R6: 510k; 0603-RES
R4: 100; 0603-RES
R7, R8, R9: 43k; 0603-RES
R10, R12, R14, R30, R31, R40: 1k; 0603-RES
R11, R13, R39, R42: 2k; 0603-RES
R15: 1.4k; 0603-RES
R16, R17, R18, R22, R26, R27, R33, R36: 10k; 0603-RES
R19, R21: 60; 0603-RES
R20, R28, R29: 1K; 0603-RES
R23, R24: 1.6K; 0603-RES
R32, R37: 10; 0603-RES
R34: 360; 0603-RES
R35: 4.7k; 0603-RES
R38: 20k; 0603-RES
R41: 8.2k; 0603-RES
RELAY: RELAY; NANO-FIT_VERTICAL-2
SHUTDOWN_H:D1: TS4148 RYG; 0805_D
SHUTDOWN_H:R1: 12K; 0603-RES
SHUTDOWN_H:R2: 43K; 0603-RES
SHUTDOWN_I:D1: TS4148 RYG; 0805_D
SHUTDOWN_I:R1: 12K; 0603-RES
SHUTDOWN_I:R2: 43K; 0603-RES
SHUTDOWN_J:D1: TS4148 RYG; 0805_D
SHUTDOWN_J:R1: 12K; 0603-RES
SHUTDOWN_J:R2: 43K; 0603-RES
SHUTDOWN_K:D1: TS4148 RYG; 0805_D
SHUTDOWN_K:R1: 12K; 0603-RES
SHUTDOWN_K:R2: 43K; 0603-RES
SOFTWARE_SHUTDOWN: SOFTWARE SHUTDOWN; G5LE-1A4
TEENSY: RED; LED-603
TEENSY3.1: TEENSY_3.2_SIMPLE
U1: HM2102NLT
U2: OPA172; SOT323-5
U3: OKI-78SR-5; OKI-78SR
U4: LTC6820; MSOP-16
U5: MCP3204; SO14
U6: STWD100PYW83F; SOT323-5
U7: SN74LVC1G08; SOT323-5
U8: CDSOT23-T24CAN-Q; SOT23
U9: TXB0104TSSOP; TSSOP-14
U10: MCP2551; SOIC-08
U11, U12, U14, U15: CPC1002N; SOP04
U13, U16: LR8; SOT89
U$3, U$4, U$5, U$6, U$7, U$8, U$9, U$10, U$11, U$13, U$14: TEST_POINTMICRO_MINIATURE; MICRO_MINIATURE
U$15, U$16, U$17: M3_MOUNTING

Connections:
60V-THRESHOLD:INPUT_POST_DIODE: 60V-THRESHOLD:D1.C, 60V-THRESHOLD:R1.1
60V_THRESHOLD_SIGNAL: 60V-THRESHOLD:D1.A, MAIN.P$1, U15.3, U$8.P$1
60V_THRESHOLD_TEENSY: 60V-THRESHOLD:R1.2, 60V-THRESHOLD:R2.1, TEENSY3.1.A6
100A_REF: 100A_REF:U1.2, CURRENT1.P$3
100A_REF:CLK: 100A_REF:C1.1, 100A_REF:U1.8
100A_REF:COM: 100A_REF:C3.1, 100A_REF:U1.1, 100A_REF:U1.6
100A_REF_FILT: 100A_REF:U1.5, U5.4
100A_SENSE: 100A_SENSE:U1.2, CURRENT1.P$2, R1.1, U2.3
100A_SENSE:CLK: 100A_SENSE:C1.1, 100A_SENSE:U1.8
100A_SENSE:COM: 100A_SENSE:C3.1, 100A_SENSE:U1.1, 100A_SENSE:U1.6
100A_SENSE_FILT: 100A_SENSE:U1.5, U5.3
300A_REF: 300A_REF:U1.2, CURRENT2.P$3
300A_REF:CLK: 300A_REF:C1.1, 300A_REF:U1.8
300A_REF:COM: 300A_REF:C3.1, 300A_REF:U1.1, 300A_REF:U1.6
300A_REF_FILT: 300A_REF:U1.5, U5.2
300A_SENSE: 300A_SENSE:U1.2, CURRENT2.P$2, R2.1
300A_SENSE:CLK: 300A_SENSE:C1.1, 300A_SENSE:U1.8
300A_SENSE:COM: 300A_SENSE:C3.1, 300A_SENSE:U1.1, 300A_SENSE:U1.6
300A_SENSE_FILT: 300A_SENSE:U1.5, U5.1
+3V3: C10.1, R11.1, R13.1, R36.1, TEENSY3.1.3.3V, U4.6, U6.5, U7.5, U9.1, U9.8, U$7.P$1
+5V: 100A_REF:C2.1, 100A_REF:U1.4, 100A_REF:U1.7, 100A_SENSE:C2.1, 100A_SENSE:U1.4, 100A_SENSE:U1.7, 300A_REF:C2.1, 300A_REF:U1.4, 300A_REF:U1.7, 300A_SENSE:C2.1, 300A_SENSE:U1.4, 300A_SENSE:U1.7, C5.1, C6.1, C7.1, C11.2, C12.2, C13.1, CURRENT1.P$1, CURRENT2.P$1, ON-LED.A, TEENSY3.1.VIN, U3.3, U4.1, U4.7, U4.8, U4.9, U4.12, U5.13, U5.14, U9.14, U10.3, U15.4, U$4.P$1
+12V: BOARDFUSE.R1, BOARDFUSE.R2, C2.2, C14.1, D3.C, ENERGYMETER.P$1, IMD.P$1, SOFTWARE_SHUTDOWN.2, U2.5, U3.1, U11.4, U12.4, U$5.P$1
+12VIN: BOARDFUSE.L1, BOARDFUSE.L2, D5.P$2, MAIN.P$4
BMS_OK: C9.2, MAIN.P$7, R16.1, R24.2, U$14.P$1
BMS_OK_3.3V: BMS-OK.A, R26.2, R34.1, U7.4, U$10.P$1
BMS_OK_PRE_FILTER: R24.1, U11.3
BMS_STATUS: D4.3, R27.2, R32.2, R33.1, TEENSY3.1.D5, U7.1
BSPD_CURR:INPUT_POST_DIODE: BSPD_CURR:D1.C, BSPD_CURR:R1.1
BSPD_CURRENT: BSPD_CURR:D1.A, MAIN.P$3, R15.2, U2.1, U$6.P$1
BSPD_CURR_TEENSY: BSPD_CURR:R1.2, BSPD_CURR:R2.1, TEENSY3.1.A7
CANH: ENERGYMETER.P$4, MAIN.P$10, R21.2, U8.2, U10.7
CANL: ENERGYMETER.P$3, MAIN.P$9, R19.2, U8.1, U10.6
CANRX: TEENSY3.1.D4(CANRX), U10.4
CANTX: TEENSY3.1.D3(CANTX), U10.1
CHARGE_ENABLE: CHARGE_ENABLE:D1.A, D2.C, MAIN.P$2
CHARGE_ENABLE:INPUT_POST_DIODE: CHARGE_ENABLE:D1.C, CHARGE_ENABLE:R1.1
CHARGE_ENABLE_TEENSY: CHARGE_ENABLE:R1.2, CHARGE_ENABLE:R2.1, TEENSY3.1.A4
CS_ADC_5V: U5.8, U9.13
CS_ADC_TEENSY: TEENSY3.1.D9(RX2), U9.2
CS_LTC6820: TEENSY3.1.D10(TX2), U4.5
DISCHARGE+: $$U$12.CONTACT2, DISCHARGE+.P$1, DISCHARGE+.P$2
GND: 60V-THRESHOLD:R2.2, 100A_REF:C1.2, 100A_REF:C2.2, 100A_REF:C3.2, 100A_REF:U1.3, 100A_SENSE:C1.2, 100A_SENSE:C2.2, 100A_SENSE:C3.2, 100A_SENSE:U1.3, 300A_REF:C1.2, 300A_REF:C2.2, 300A_REF:C3.2, 300A_REF:U1.3, 300A_SENSE:C1.2, 300A_SENSE:C2.2, 300A_SENSE:C3.2, 300A_SENSE:U1.3, $$U$12.COIL+, BSPD_CURR:R2.2, C2.1, C3.2, C4.1, C5.2, C6.2, C7.2, C8.1, C9.1, C10.2, C11.1, C12.1, C13.2, C14.2, CHARGE_ENABLE:R2.2, CURRENT1.P$4, CURRENT2.P$4, D1.A, D4.1, D5.P$1, ENERGYMETER.P$2, IMD.P$2, IMD.P$3, IMD.P$4, IMD_OK:R2.2, MAIN.P$5, Q1.2, R1.2, R2.2, R10.2, R14.2, R16.2, R17.1, R18.2, R20.2, R22.2, R25.2, R26.1, R27.1, R28.2, R29.2, R30.1, R31.2, R33.2, R36.2, RELAY.P$2, SHUTDOWN_H:R2.2, SHUTDOWN_I:R2.2, SHUTDOWN_J:R2.2, SHUTDOWN_K:R2.2, TEENSY3.1.AGND, TEENSY3.1.GND, U2.2, U3.2, U4.13, U4.14, U5.7, U5.12, U6.2, U6.3, U7.3, U8.3, U9.7, U10.2, U11.2, U12.2, U$3.P$1
HV+FUSED: HV+FUSED.P$1, HV+FUSED.P$2, IMD+.P$1, IMD+.P$2, R3.2, U13.1, U16.1
HV+UNFUSED: $$U$12.CONTACT1, C1.P$1, HV+UNFUSED.P$1, HV+UNFUSED.P$2
HV-FUSED: HV-FUSED.P$1, HV-FUSED.P$2, IMD-.P$1, IMD-.P$2, INDICATOR1.P$2, Q2.3, R9.1, R38.2, R41.2
HV-UNFUSED: C1.P$2, DISCHARGE-.P$1, DISCHARGE-.P$2, HV-UNFUSED.P$1, HV-UNFUSED.P$2
IM: U1.P$10, U4.10
IMD_OK: C8.2, IMD_OK:D1.A, MAIN.P$8, R18.1, R23.2, U$13.P$1
IMD_OK:INPUT_POST_DIODE: IMD_OK:D1.C, IMD_OK:R1.1
IMD_OK_12V: IMD.P$5, IMD-OK.A, R22.1, R35.1, U$11.P$1
IMD_OK_PRE_FILTER: R23.1, U12.3
IMD_OK_TEENSY: IMD_OK:R1.2, IMD_OK:R2.1, TEENSY3.1.A5
IP: U1.P$12, U4.11
ISOSPI-M: ISOSPI.P$2, R4.2, U1.P$3
ISOSPI-P: ISOSPI.P$1, R4.1, U1.P$1
MISO_5V: U5.10, U9.11
MISO_TEENSY: R13.2, TEENSY3.1.D12, U4.3, U9.4
MOSI_5V: U5.9, U9.12
MOSI_TEENSY: R11.2, TEENSY3.1.D11, U4.2, U9.3
unnamed: D3.A, Q1.3, SOFTWARE_SHUTDOWN.1
unnamed: ON-LED.C, R20.1
unnamed: Q2.1, R37.2
unnamed: R39.2, U13.2, U13.PAD, U14.4
unnamed: R38.1, R39.1, U13.3
unnamed: R10.1, R15.1, U2.4
unnamed: R35.2, U12.1
unnamed: IMD-OK.C, R28.1
unnamed: C4.2, R19.1, R21.1
unnamed: Q1.1, R32.1
unnamed: R34.2, U11.1
unnamed: BMS-OK.C, R29.1
unnamed: R42.2, U15.1, U16.2, U16.PAD
unnamed: R3.1, R5.1
unnamed: R5.2, R6.2
unnamed: R30.2, U10.8
unnamed: R7.1, R8.1
unnamed: R8.2, R9.2
unnamed: R31.1, TEENSY.C
unnamed: R40.1, U14.2
unnamed: R12.1, U4.16
unnamed: R12.2, R14.1, U4.15
unnamed: U14.1, U15.2
unnamed: INDICATOR1.P$1, U14.3
unnamed: C3.1, U1.P$11
unnamed: R41.1, R42.1, U16.3
unnamed: R6.1, R7.2, R37.1
unnamed: Q2.2(TAB), R40.2
SCK_5V: U5.11, U9.10
SCK_TEENSY: TEENSY3.1.D13, U4.4, U9.5
SHUTDOWN_H: MAIN.P$6, SHUTDOWN_H:D1.A, SOFTWARE_SHUTDOWN.P
SHUTDOWN_H:INPUT_POST_DIODE: SHUTDOWN_H:D1.C, SHUTDOWN_H:R1.1
SHUTDOWN_H_TEENSY: SHUTDOWN_H:R1.2, SHUTDOWN_H:R2.1, TEENSY3.1.A3
SHUTDOWN_I: INTERLOCK1.P$1, SHUTDOWN_I:D1.A, SOFTWARE_SHUTDOWN.S
SHUTDOWN_I:INPUT_POST_DIODE: SHUTDOWN_I:D1.C, SHUTDOWN_I:R1.1
SHUTDOWN_I_TEENSY: SHUTDOWN_I:R1.2, SHUTDOWN_I:R2.1, TEENSY3.1.A2
SHUTDOWN_J: INTERLOCK1.P$2, INTERLOCK2.P$1, SHUTDOWN_J:D1.A
SHUTDOWN_J:INPUT_POST_DIODE: SHUTDOWN_J:D1.C, SHUTDOWN_J:R1.1
SHUTDOWN_J_TEENSY: SHUTDOWN_J:R1.2, SHUTDOWN_J:R2.1, TEENSY3.1.A1
SHUTDOWN_K: $$U$12.COIL-, D1.C, D2.A, INTERLOCK2.P$2, RELAY.P$1, SHUTDOWN_K:D1.A
SHUTDOWN_K:INPUT_POST_DIODE: SHUTDOWN_K:D1.C, SHUTDOWN_K:R1.1
SHUTDOWN_K_TEENSY: SHUTDOWN_K:R1.2, SHUTDOWN_K:R2.1, TEENSY3.1.A0
TEENSY_STATUS: TEENSY.A, TEENSY3.1.D6
WATCHDOG_INPUT: R25.1, TEENSY3.1.D7(RX3), U6.4
WATCHDOG_OK: R17.2, U6.1, U7.2, U$9.P$1
