lpozdneev/team-buzz/Schematics/HyTech BMS Segment/BMS Segment rev14.brd

## EAGLE design Schematics/HyTech BMS Segment/BMS Segment rev14.brd (2021-02-03, an earlier design)

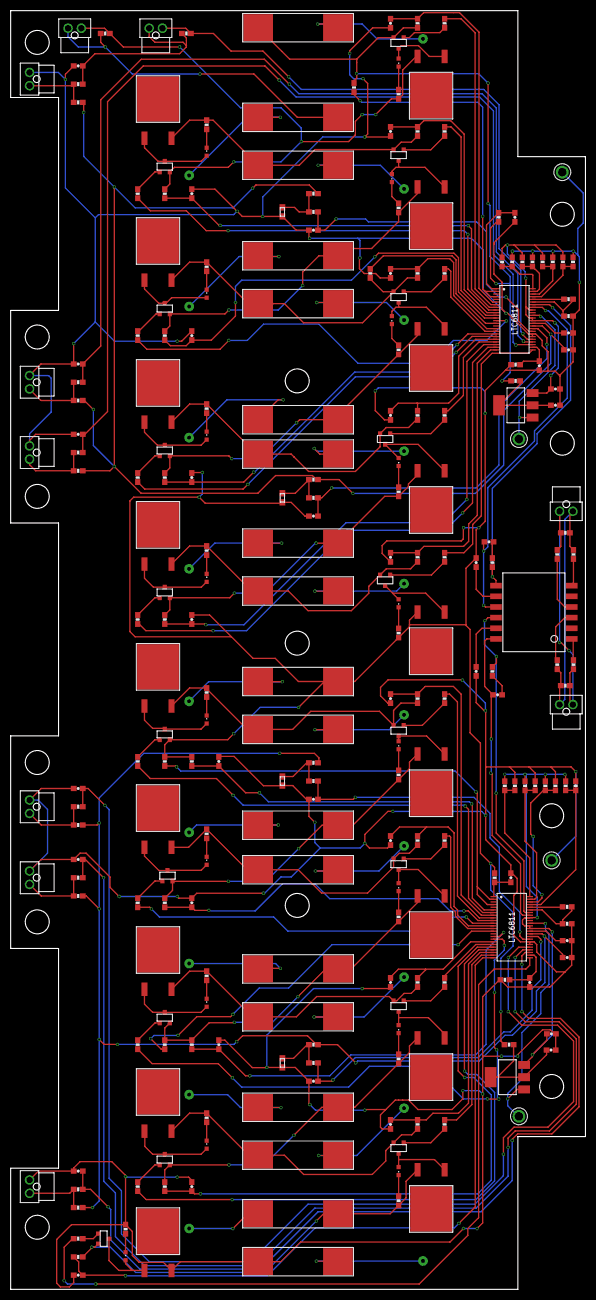
[picture p47: board BMS Segment rev14.brd from above]

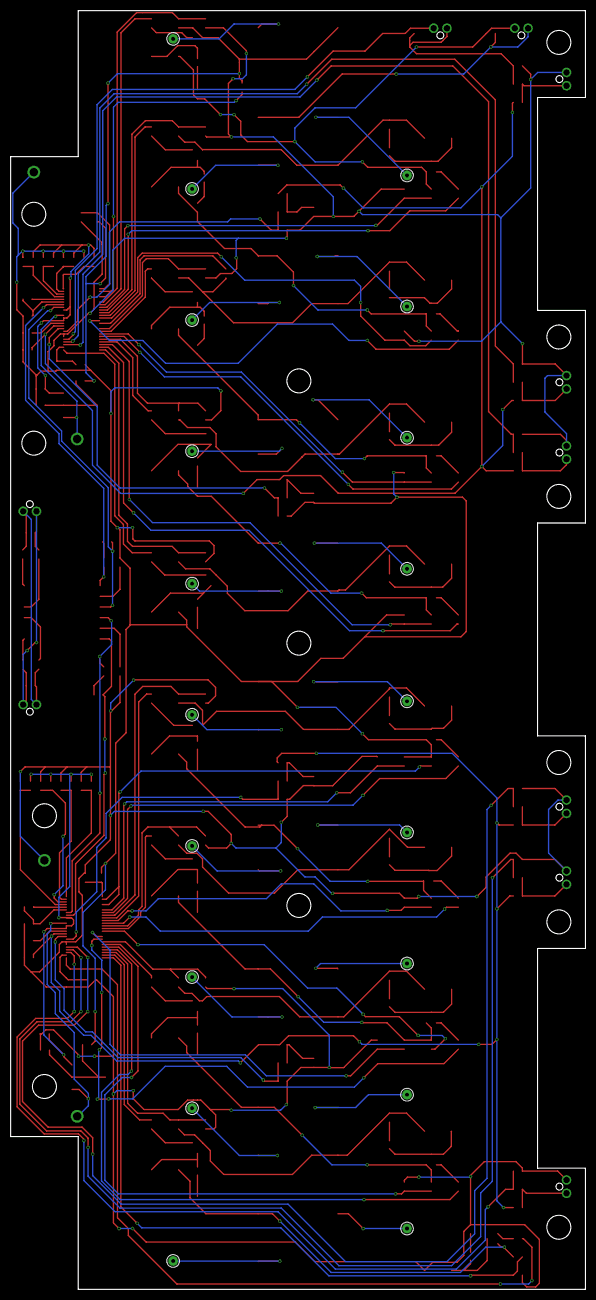
[picture p48: board BMS Segment rev14.brd from below]

Board: 2 copper layers, 108.0 x 240.3 mm, 286 parts (19 on the bottom side), 194 nets.

Parts:
AMS_CELL_TEST: AMS_CELL_TEST; NANO-FIT_VERTICAL-2
AMS_THERM_TEST: AMS_THERM_TEST; NANO-FIT_VERTICAL-2
C1_A, C1_B, C2_A, C2_B, C8_A, C8_B: 1uF; 0603-CAP
C3_A, C3_B: 15pF; 0603-CAP
C4_A, C4_B, C5_A: 10nF; 0603-CAP
C6_A, C6_B, C7_A, C7_B: 100nF; 0603-CAP
CELL0, CELL1, CELL2, CELL3, CELL4, CELL5, CELL6, CELL7, CELL8, CELL9, CELL10, CELL11, CELL12, CELL13, CELL14, CELL15, CELL16, CELL17, CELL18: BATTERY_SPRING_SPRING_CONTACT; CONTACT_SPRING
C_5: 10nF; 0603-CAP
DRAIN1:C, DRAIN2:C, DRAIN3:C, DRAIN4:C, DRAIN5:C, DRAIN6:C, DRAIN7:C, DRAIN8:C, DRAIN9:C, DRAIN10:C, DRAIN11:C, DRAIN12:C, DRAIN13:C, DRAIN14:C, DRAIN15:C, DRAIN16:C, DRAIN17:C, DRAIN18:C: 10nF; 0603-CAP
DRAIN1:DISCHARGE, DRAIN2:DISCHARGE, DRAIN3:DISCHARGE, DRAIN4:DISCHARGE, DRAIN5:DISCHARGE, DRAIN6:DISCHARGE, DRAIN7:DISCHARGE, DRAIN8:DISCHARGE, DRAIN9:DISCHARGE, DRAIN10:DISCHARGE, DRAIN11:DISCHARGE, DRAIN12:DISCHARGE, DRAIN13:DISCHARGE, DRAIN14:DISCHARGE, DRAIN15:DISCHARGE, DRAIN16:DISCHARGE, DRAIN17:DISCHARGE, DRAIN18:DISCHARGE: 5R; PWR163
DRAIN1:GATE, DRAIN2:GATE, DRAIN3:GATE, DRAIN4:GATE, DRAIN5:GATE, DRAIN6:GATE, DRAIN7:GATE, DRAIN8:GATE, DRAIN9:GATE, DRAIN10:GATE, DRAIN11:GATE, DRAIN12:GATE, DRAIN13:GATE, DRAIN14:GATE, DRAIN15:GATE, DRAIN16:GATE, DRAIN17:GATE, DRAIN18:GATE: 3K3; 0603-RES
DRAIN1:LED1, DRAIN2:LED1, DRAIN3:LED1, DRAIN4:LED1, DRAIN5:LED1, DRAIN6:LED1, DRAIN7:LED1, DRAIN8:LED1, DRAIN9:LED1, DRAIN10:LED1, DRAIN11:LED1, DRAIN12:LED1, DRAIN13:LED1, DRAIN14:LED1, DRAIN15:LED1, DRAIN16:LED1, DRAIN17:LED1, DRAIN18:LED1: RED; LED-603
DRAIN1:PFET, DRAIN2:PFET, DRAIN3:PFET, DRAIN4:PFET, DRAIN5:PFET, DRAIN6:PFET, DRAIN7:PFET, DRAIN8:PFET, DRAIN9:PFET, DRAIN10:PFET, DRAIN11:PFET, DRAIN12:PFET, DRAIN13:PFET, DRAIN14:PFET, DRAIN15:PFET, DRAIN16:PFET, DRAIN17:PFET, DRAIN18:PFET: P-CHANNEL_MOSFET_DMP3099L-7; SOT23
DRAIN1:R, DRAIN2:R, DRAIN3:R, DRAIN4:R, DRAIN5:R, DRAIN6:R, DRAIN7:R, DRAIN8:R, DRAIN9:R, DRAIN10:R, DRAIN11:R, DRAIN12:R, DRAIN13:R, DRAIN14:R, DRAIN15:R, DRAIN16:R, DRAIN17:R, DRAIN18:R: 100R; 0603-RES
DRAIN1:R1, DRAIN2:R1, DRAIN3:R1, DRAIN4:R1, DRAIN5:R1, DRAIN6:R1, DRAIN7:R1, DRAIN8:R1, DRAIN9:R1, DRAIN10:R1, DRAIN11:R1, DRAIN12:R1, DRAIN13:R1, DRAIN14:R1, DRAIN15:R1, DRAIN16:R1, DRAIN17:R1, DRAIN18:R1: 806R; 0603-RES
F0, F1, F2, F3, F4, F5, F6, F7, F8, F9, F10, F11, F12, F13, F14, F15, F16, F17, F18: 0001.2704.11; 5X20MM_FUSE
ISOSPI_A: ISOSPI; NANO-FIT_VERTICAL-2
ISOSPI_B: ISOSPI; NANO-FIT_VERTICAL-2
J1_A, J1_B, J2_A, J2_B, J3_A, J3_B, J4_A, J4_B, J5_A, J5_B, J6_A, J6_B, J7_A, J7_B, J8_A, J8_B: 0R; 0603-RES
J_CELL_A: 0R; 0603-RES
J_THERM_A: 0R; 0603-RES
Q1, Q2: NSV1C201MZ4; SOT223
R1_A, R1_B, R2_A, R2_B: 100R; 0603-RES
R3_A, R3_B: 402R; 0603-RES
R4_A, R4_B, R5_A, R5_B: 22R; 0603-RES
RB1_A, RB1_B: 1K2; 0603-RES
RB2_A, RB2_B: 806R; 0603-RES
RIN_A: 100R; 0603-RES
RIN_B: 100R; 0603-RES
RM_A: 100R; 0603-RES
RM_B: 100R; 0603-RES
RU1_A, RU1_B, RU2_A, RU2_B: 100R; 0603-RES
THERM1, THERM2, THERM3, THERM4: 10K; 0603
THERM1_A, THERM1_B, THERM2_A, THERM2_B, THERM3_A, THERM3_B: THERMISTOR; NANO-FIT_VERTICAL-2
THERM_FILTER1:C, THERM_FILTER2:C, THERM_FILTER3:C, THERM_FILTER4:C, THERM_FILTER5:C, THERM_FILTER6:C, THERM_FILTER7:C, THERM_FILTER8:C, THERM_FILTER9:C, THERM_FILTER10:C: 10nF; 0603-CAP
THERM_FILTER1:R, THERM_FILTER2:R, THERM_FILTER3:R, THERM_FILTER4:R, THERM_FILTER5:R, THERM_FILTER6:R, THERM_FILTER7:R, THERM_FILTER8:R, THERM_FILTER9:R, THERM_FILTER10:R: 100R; 0603-RES
THERM_FILTER1:R1, THERM_FILTER2:R1, THERM_FILTER3:R1, THERM_FILTER4:R1, THERM_FILTER5:R1, THERM_FILTER6:R1, THERM_FILTER7:R1, THERM_FILTER8:R1, THERM_FILTER9:R1, THERM_FILTER10:R1: 10K; 0603-RES
TRANSFORMER: HM2102NLT
U1, U2: LTC6811-2; LTC6811
U$5, U$6, U$7, U$8: TEST_POINT
U$9, U$10, U$11, U$12, U$13, U$14, U$15, U$16, U$17, U$18, U$19, U$26, U$27: M4_MOUNTING

Connections:
C0_A: C5_A.1, R2_A.2, U1.26
C0_B: C_5.1, R2_B.2, U2.26
C1_A: DRAIN10:C.1, DRAIN10:R.2, U1.24
C1_B: DRAIN1:C.1, DRAIN1:R.2, U2.24
C2_A: DRAIN11:C.1, DRAIN11:R.2, U1.22
C2_B: DRAIN2:C.1, DRAIN2:R.2, U2.22
C3_A: DRAIN12:C.1, DRAIN12:R.2, U1.20
C3_B: DRAIN3:C.1, DRAIN3:R.2, U2.20
C4_A: DRAIN13:C.1, DRAIN13:R.2, U1.18
C4_B: DRAIN4:C.1, DRAIN4:R.2, U2.18
C5_A: DRAIN14:C.1, DRAIN14:R.2, U1.16
C5_B: DRAIN5:C.1, DRAIN5:R.2, U2.16
C7_A: DRAIN15:C.1, DRAIN15:R.2, U1.12
C7_B: DRAIN6:C.1, DRAIN6:R.2, U2.12
C8_A: DRAIN16:C.1, DRAIN16:R.2, U1.10
C8_B: DRAIN7:C.1, DRAIN7:R.2, U2.10
C9_A: DRAIN17:C.1, DRAIN17:R.2, U1.8
C9_B: DRAIN8:C.1, DRAIN8:R.2, U2.8
C10_A: DRAIN18:C.1, DRAIN18:R.2, U1.6
C10_B: DRAIN9:C.1, DRAIN9:R.2, U2.6
CC0: CELL0.P$1, F0.P$1
CC1: CELL1.P$1, F1.P$1
CC2: CELL2.P$1, F2.P$1
CC3: CELL3.P$1, F3.P$1
CC4: CELL4.P$1, F4.P$1
CC5: CELL5.P$1, F5.P$1
CC6: CELL6.P$1, F6.P$1
CC7: CELL7.P$1, F7.P$1
CC8: CELL8.P$1, F8.P$1
CC9: CELL9.P$1, F9.P$1
CC10: CELL10.P$1, F10.P$1
CC11: CELL11.P$1, F11.P$1
CC12: CELL12.P$1, F12.P$1
CC13: CELL13.P$1, F13.P$1
CC14: CELL14.P$1, F14.P$1
CC15: CELL15.P$1, F15.P$1
CC16: CELL16.P$1, F16.P$1
CC17: CELL17.P$1, F17.P$1
CC18: CELL18.P$1, F18.P$1
DRAIN1:GATE: DRAIN1:GATE.1, DRAIN1:PFET.1
DRAIN1:N$1: DRAIN1:DISCHARGE.1, DRAIN1:LED1.A, DRAIN1:PFET.3
DRAIN1:N$2: DRAIN1:LED1.C, DRAIN1:R1.2
DRAIN2:GATE: DRAIN2:GATE.1, DRAIN2:PFET.1
DRAIN2:N$1: DRAIN2:DISCHARGE.1, DRAIN2:LED1.A, DRAIN2:PFET.3
DRAIN2:N$2: DRAIN2:LED1.C, DRAIN2:R1.2
DRAIN3:GATE: DRAIN3:GATE.1, DRAIN3:PFET.1
DRAIN3:N$1: DRAIN3:DISCHARGE.1, DRAIN3:LED1.A, DRAIN3:PFET.3
DRAIN3:N$2: DRAIN3:LED1.C, DRAIN3:R1.2
DRAIN4:GATE: DRAIN4:GATE.1, DRAIN4:PFET.1
DRAIN4:N$1: DRAIN4:DISCHARGE.1, DRAIN4:LED1.A, DRAIN4:PFET.3
DRAIN4:N$2: DRAIN4:LED1.C, DRAIN4:R1.2
DRAIN5:GATE: DRAIN5:GATE.1, DRAIN5:PFET.1
DRAIN5:N$1: DRAIN5:DISCHARGE.1, DRAIN5:LED1.A, DRAIN5:PFET.3
DRAIN5:N$2: DRAIN5:LED1.C, DRAIN5:R1.2
DRAIN6:GATE: DRAIN6:GATE.1, DRAIN6:PFET.1
DRAIN6:N$1: DRAIN6:DISCHARGE.1, DRAIN6:LED1.A, DRAIN6:PFET.3
DRAIN6:N$2: DRAIN6:LED1.C, DRAIN6:R1.2
DRAIN7:GATE: DRAIN7:GATE.1, DRAIN7:PFET.1
DRAIN7:N$1: DRAIN7:DISCHARGE.1, DRAIN7:LED1.A, DRAIN7:PFET.3
DRAIN7:N$2: DRAIN7:LED1.C, DRAIN7:R1.2
DRAIN8:GATE: DRAIN8:GATE.1, DRAIN8:PFET.1
DRAIN8:N$1: DRAIN8:DISCHARGE.1, DRAIN8:LED1.A, DRAIN8:PFET.3
DRAIN8:N$2: DRAIN8:LED1.C, DRAIN8:R1.2
DRAIN9:GATE: DRAIN9:GATE.1, DRAIN9:PFET.1
DRAIN9:N$1: DRAIN9:DISCHARGE.1, DRAIN9:LED1.A, DRAIN9:PFET.3
DRAIN9:N$2: DRAIN9:LED1.C, DRAIN9:R1.2
DRAIN10:GATE: DRAIN10:GATE.1, DRAIN10:PFET.1
DRAIN10:N$1: DRAIN10:DISCHARGE.1, DRAIN10:LED1.A, DRAIN10:PFET.3
DRAIN10:N$2: DRAIN10:LED1.C, DRAIN10:R1.2
DRAIN11:GATE: DRAIN11:GATE.1, DRAIN11:PFET.1
DRAIN11:N$1: DRAIN11:DISCHARGE.1, DRAIN11:LED1.A, DRAIN11:PFET.3
DRAIN11:N$2: DRAIN11:LED1.C, DRAIN11:R1.2
DRAIN12:GATE: DRAIN12:GATE.1, DRAIN12:PFET.1
DRAIN12:N$1: DRAIN12:DISCHARGE.1, DRAIN12:LED1.A, DRAIN12:PFET.3
DRAIN12:N$2: DRAIN12:LED1.C, DRAIN12:R1.2
DRAIN13:GATE: DRAIN13:GATE.1, DRAIN13:PFET.1
DRAIN13:N$1: DRAIN13:DISCHARGE.1, DRAIN13:LED1.A, DRAIN13:PFET.3
DRAIN13:N$2: DRAIN13:LED1.C, DRAIN13:R1.2
DRAIN14:GATE: DRAIN14:GATE.1, DRAIN14:PFET.1
DRAIN14:N$1: DRAIN14:DISCHARGE.1, DRAIN14:LED1.A, DRAIN14:PFET.3
DRAIN14:N$2: DRAIN14:LED1.C, DRAIN14:R1.2
DRAIN15:GATE: DRAIN15:GATE.1, DRAIN15:PFET.1
DRAIN15:N$1: DRAIN15:DISCHARGE.1, DRAIN15:LED1.A, DRAIN15:PFET.3
DRAIN15:N$2: DRAIN15:LED1.C, DRAIN15:R1.2
DRAIN16:GATE: DRAIN16:GATE.1, DRAIN16:PFET.1
DRAIN16:N$1: DRAIN16:DISCHARGE.1, DRAIN16:LED1.A, DRAIN16:PFET.3
DRAIN16:N$2: DRAIN16:LED1.C, DRAIN16:R1.2
DRAIN17:GATE: DRAIN17:GATE.1, DRAIN17:PFET.1
DRAIN17:N$1: DRAIN17:DISCHARGE.1, DRAIN17:LED1.A, DRAIN17:PFET.3
DRAIN17:N$2: DRAIN17:LED1.C, DRAIN17:R1.2
DRAIN18:GATE: DRAIN18:GATE.1, DRAIN18:PFET.1
DRAIN18:N$1: DRAIN18:DISCHARGE.1, DRAIN18:LED1.A, DRAIN18:PFET.3
DRAIN18:N$2: DRAIN18:LED1.C, DRAIN18:R1.2
DRIVE_A: Q1.1, U1.38, U$8.P$1
DRIVE_B: Q2.1, U2.38, U$7.P$1
GPIO1_A: THERM_FILTER6:C.1, THERM_FILTER6:R.1, U1.27
GPIO1_B: THERM_FILTER1:C.1, THERM_FILTER1:R.1, U2.27
GPIO2_A: THERM_FILTER7:C.1, THERM_FILTER7:R.1, U1.28
GPIO2_B: THERM_FILTER2:C.1, THERM_FILTER2:R.1, U2.28
GPIO3_A_POST: AMS_THERM_TEST.P$2, J_THERM_A.1, U1.29
GPIO3_A_PRE: AMS_THERM_TEST.P$1, J_THERM_A.2, THERM_FILTER8:C.1, THERM_FILTER8:R.1
GPIO3_B: THERM_FILTER3:C.1, THERM_FILTER3:R.1, U2.29
GPIO4_A: THERM_FILTER9:C.1, THERM_FILTER9:R.1, U1.32
GPIO4_B: THERM_FILTER4:C.1, THERM_FILTER4:R.1, U2.32
GPIO5_A: THERM_FILTER10:C.1, THERM_FILTER10:R.1, U1.33
GPIO5_B: THERM_FILTER5:C.1, THERM_FILTER5:R.1, U2.33
IM_A: C3_A.2, TRANSFORMER.P$9, U1.41
IM_B: C3_B.2, TRANSFORMER.P$12, U2.41
IP_A: R3_A.1, TRANSFORMER.P$7, U1.42
IP_B: R3_B.1, TRANSFORMER.P$10, U2.42
ISOSPI-M: ISOSPI_A.P$2, ISOSPI_B.P$2, R5_A.2, R5_B.2, RM_A.2, RM_B.2
ISOSPI-P: ISOSPI_A.P$1, ISOSPI_B.P$1, R4_A.2, R4_B.2, RM_A.1, RM_B.1
unnamed: C4_B.1, TRANSFORMER.P$11
unnamed: RB1_B.2, U2.44
unnamed: THERM1_B.P$1, THERM_FILTER1:R.2, THERM_FILTER1:R1.2
unnamed: RB1_B.1, RB2_B.2, U2.43
unnamed: R4_B.1, TRANSFORMER.P$3
unnamed: RB1_A.2, U1.44
unnamed: R5_B.1, TRANSFORMER.P$1
unnamed: J7_B.1, J8_B.1, U2.48
unnamed: J5_B.1, J6_B.1, U2.47
unnamed: C3_B.1, R3_B.2
unnamed: J3_B.1, J4_B.1, U2.46
unnamed: J1_B.1, J2_B.1, U2.45
unnamed: THERM1.2, THERM_FILTER5:R.2, THERM_FILTER5:R1.2
unnamed: THERM2_B.P$1, THERM_FILTER2:R.2, THERM_FILTER2:R1.2
unnamed: THERM2.2, THERM_FILTER4:R.2, THERM_FILTER4:R1.2
unnamed: RB1_A.1, RB2_A.2, U1.43
unnamed: C4_A.1, TRANSFORMER.P$8
unnamed: R4_A.1, TRANSFORMER.P$6
unnamed: R5_A.1, TRANSFORMER.P$4
unnamed: C3_A.1, R3_A.2
unnamed: THERM3_B.P$1, THERM_FILTER3:R.2, THERM_FILTER3:R1.2
unnamed: J7_A.1, J8_A.1, U1.48
unnamed: J5_A.1, J6_A.1, U1.47
unnamed: J3_A.1, J4_A.1, U1.46
unnamed: J1_A.1, J2_A.1, U1.45
unnamed: THERM4.2, THERM_FILTER9:R.2, THERM_FILTER9:R1.2
unnamed: THERM3_A.P$1, THERM_FILTER8:R.2, THERM_FILTER8:R1.2
unnamed: THERM3.2, THERM_FILTER10:R.2, THERM_FILTER10:R1.2
unnamed: THERM2_A.P$1, THERM_FILTER7:R.2, THERM_FILTER7:R1.2
unnamed: THERM1_A.P$1, THERM_FILTER6:R.2, THERM_FILTER6:R1.2
S1_A: DRAIN10:GATE.2, U1.25
S1_B: DRAIN1:GATE.2, U2.25
S2_A: DRAIN11:GATE.2, U1.23
S2_B: DRAIN2:GATE.2, U2.23
S3_A: DRAIN12:GATE.2, U1.21
S3_B: DRAIN3:GATE.2, U2.21
S4_A: DRAIN13:GATE.2, U1.19
S4_B: DRAIN4:GATE.2, U2.19
S5_A: DRAIN14:GATE.2, U1.17
S5_B: DRAIN5:GATE.2, U2.17
S7_A: DRAIN15:GATE.2, U1.13
S7_B: DRAIN6:GATE.2, U2.13
S8_A: DRAIN16:GATE.2, U1.11
S8_B: DRAIN7:GATE.2, U2.11
S9_A: DRAIN17:GATE.2, U1.9
S9_B: DRAIN8:GATE.2, U2.9
S10_A: DRAIN18:GATE.2, U1.7
S10_B: DRAIN9:GATE.2, U2.7
SENSE1: DRAIN1:PFET.2, DRAIN1:R.1, DRAIN2:DISCHARGE.2, DRAIN2:R1.1, F1.P$2
SENSE2: DRAIN2:PFET.2, DRAIN2:R.1, DRAIN3:DISCHARGE.2, DRAIN3:R1.1, F2.P$2
SENSE3: DRAIN3:PFET.2, DRAIN3:R.1, DRAIN4:DISCHARGE.2, DRAIN4:R1.1, F3.P$2
SENSE4: DRAIN4:PFET.2, DRAIN4:R.1, DRAIN5:DISCHARGE.2, DRAIN5:R1.1, F4.P$2
SENSE5: DRAIN5:PFET.2, DRAIN5:R.1, DRAIN6:DISCHARGE.2, DRAIN6:R1.1, F5.P$2, RU2_B.1
SENSE6: DRAIN6:PFET.2, DRAIN6:R.1, DRAIN7:DISCHARGE.2, DRAIN7:R1.1, F6.P$2
SENSE7: DRAIN7:PFET.2, DRAIN7:R.1, DRAIN8:DISCHARGE.2, DRAIN8:R1.1, F7.P$2
SENSE8: DRAIN8:PFET.2, DRAIN8:R.1, DRAIN9:DISCHARGE.2, DRAIN9:R1.1, F8.P$2
SENSE10: DRAIN10:PFET.2, DRAIN10:R.1, DRAIN11:DISCHARGE.2, DRAIN11:R1.1, F10.P$2
SENSE11: DRAIN11:PFET.2, DRAIN11:R.1, DRAIN12:DISCHARGE.2, DRAIN12:R1.1, F11.P$2
SENSE12: DRAIN12:PFET.2, DRAIN12:R.1, DRAIN13:DISCHARGE.2, DRAIN13:R1.1, F12.P$2
SENSE13: DRAIN13:PFET.2, DRAIN13:R.1, DRAIN14:DISCHARGE.2, DRAIN14:R1.1, F13.P$2
SENSE14: DRAIN14:PFET.2, DRAIN14:R.1, DRAIN15:DISCHARGE.2, DRAIN15:R1.1, F14.P$2, RU2_A.1
SENSE15: DRAIN15:PFET.2, DRAIN15:R.1, DRAIN16:DISCHARGE.2, DRAIN16:R1.1, F15.P$2
SENSE16: DRAIN16:PFET.2, DRAIN16:R.1, DRAIN17:DISCHARGE.2, DRAIN17:R1.1, F16.P$2
SENSE17_POST: AMS_CELL_TEST.P$2, DRAIN17:PFET.2, DRAIN17:R.1, DRAIN18:DISCHARGE.2, DRAIN18:R1.1, J_CELL_A.2
SENSE17_PRE: AMS_CELL_TEST.P$1, F17.P$2, J_CELL_A.1
SENSE18: DRAIN18:PFET.2, DRAIN18:R.1, F18.P$2, R1_A.1, RIN_A.1, RU1_A.1
UNUSED1_A: RU1_A.2, U1.2, U1.4
UNUSED1_B: RU1_B.2, U2.2, U2.4
UNUSED2_A: RU2_A.2, U1.14
UNUSED2_B: RU2_B.2, U2.14
V+_A: C6_A.1, R1_A.2, U1.1
V+_B: C6_B.1, R1_B.2, U2.1
V-_A: C1_A.2, C2_A.2, C4_A.2, C5_A.2, C6_A.2, C7_A.2, C8_A.2, DRAIN9:PFET.2, DRAIN9:R.1, DRAIN10:C.2, DRAIN10:DISCHARGE.2, DRAIN10:R1.1, DRAIN11:C.2, DRAIN12:C.2, DRAIN13:C.2, DRAIN14:C.2, DRAIN15:C.2, DRAIN16:C.2, DRAIN17:C.2, DRAIN18:C.2, F9.P$2, J1_A.2, J3_A.2, J5_A.2, J7_A.2, R1_B.1, R2_A.1, RB2_A.1, RIN_B.1, RU1_B.1, THERM1_A.P$2, THERM2_A.P$2, THERM3.1, THERM3_A.P$2, THERM4.1, THERM_FILTER6:C.2, THERM_FILTER7:C.2, THERM_FILTER8:C.2, THERM_FILTER9:C.2, THERM_FILTER10:C.2, U1.30, U1.31, U$5.P$1
V-_B: C1_B.2, C2_B.2, C4_B.2, C6_B.2, C7_B.2, C8_B.2, C_5.2, DRAIN1:C.2, DRAIN1:DISCHARGE.2, DRAIN1:R1.1, DRAIN2:C.2, DRAIN3:C.2, DRAIN4:C.2, DRAIN5:C.2, DRAIN6:C.2, DRAIN7:C.2, DRAIN8:C.2, DRAIN9:C.2, F0.P$2, J1_B.2, J3_B.2, J5_B.2, J7_B.2, R2_B.1, RB2_B.1, THERM1.1, THERM1_B.P$2, THERM2.1, THERM2_B.P$2, THERM3_B.P$2, THERM_FILTER1:C.2, THERM_FILTER2:C.2, THERM_FILTER3:C.2, THERM_FILTER4:C.2, THERM_FILTER5:C.2, U2.30, U2.31, U$6.P$1
VIN_A: C7_A.1, Q1.2, Q1.4, RIN_A.2
VIN_B: C7_B.1, Q2.2, Q2.4, RIN_B.2
VREF1_A: C2_A.1, U1.35
VREF1_B: C2_B.1, U2.35
VREF2_A: C1_A.1, THERM_FILTER6:R1.1, THERM_FILTER7:R1.1, THERM_FILTER8:R1.1, THERM_FILTER9:R1.1, THERM_FILTER10:R1.1, U1.34
VREF2_B: C1_B.1, THERM_FILTER1:R1.1, THERM_FILTER2:R1.1, THERM_FILTER3:R1.1, THERM_FILTER4:R1.1, THERM_FILTER5:R1.1, U2.34
VREG_A: C8_A.1, J2_A.2, J4_A.2, J6_A.2, J8_A.2, Q1.3, U1.36, U1.37, U1.40
VREG_B: C8_B.1, J2_B.2, J4_B.2, J6_B.2, J8_B.2, Q2.3, U2.36, U2.37, U2.40
