lpozdneev/team-buzz/(commit log)

2021-02-03 added HyTech BMS schematics
    [BMS Segment rev10.brd, BMS Segment rev10.sch, BMS Segment rev11.brd, BMS Segment rev11.sch, BMS Segment rev12.brd, BMS Segment rev12.sch, BMS Segment rev13.brd, BMS Segment rev13.sch]
2021-02-03 inital commit for battery analysis
    [HyTech Racing Cell Validation Summary.xlsx, soc_ocv_data.csv]
2021-02-03 added HyTech HV control board schematics
    [HV Board rev11.brd, HV Board rev11.sch, HV Board rev12.brd, HV Board rev12.sch, HV Board rev13.brd, HV Board rev13.sch]
2021-02-03 got an inital plot going
    [dcir_data.csv]
2021-02-05 first draft of the full system diagram
    [Full System Diagram rev1.sch]
2021-03-03 added current sensor into the system diagram and added some schematic pictures
    [Full System Diagram rev1.sch]
2021-03-20 controller board WiP
    [Cell Charger Controller rev1.sch]
2021-03-20 added HyTech Eagle libraries
    [Adafruit INA260.brd, Adafruit INA260.sch]
2021-03-22 board almost done
    [Cell Charger Controller rev1.brd, Cell Charger Controller rev1.sch]
2021-03-23 charger controller board ready for review
    [Cell Charger Controller rev1.brd, Cell Charger Controller rev1.sch]
2021-03-23 charger BMS WiP
    [Cell Charger BMS rev1.brd, Cell Charger BMS rev1.sch]
2021-03-23 charger BMS almost done
    [Cell Charger BMS rev1.brd, Cell Charger BMS rev1.sch]
2021-03-29 small changes to the controller board
    [Cell Charger Controller rev1.brd, Cell Charger Controller rev1.sch]
2021-03-29 generated gerbers for charger controller
    [Cell Charger Controller rev1.brd, Cell Charger Controller rev1.sch]
2021-04-21 Current Sensor Demo
